StephenRJohns/sienna_camper/gemini_dimensions_prompt.md

I'm building a camper conversion platform for a Toyota Sienna minivan (fill in exact year and trim, e.g. "2022 Toyota Sienna XLE") and need precise cargo-area dimensions and obstruction locations for the specific configuration below. I'm using these numbers to build a parametric 3D model, so I need real measurements or the most authoritative estimates you can find (owner's manual specs, dimensional diagrams, teardown/conversion write-ups), with a source or reasoning for each — not a guess presented as fact. Where you're not confident, say so explicitly rather than rounding to a plausible-sounding number.

**Configuration:** 2nd row seats installed and pushed/slid fully forward on their tracks (not removed). 3rd row seats folded flat into the floor well. Cargo build sits on top of the folded 3rd row and behind the compressed 2nd row.

## Dimensions needed

1. **Maximum usable interior length**, measured from the inside face of the closed rear liftgate/hatch to the back of the 2nd-row seats when they are pushed fully forward on their tracks. Note if this changes between the floor level and up higher (liftgates are often curved, reducing usable length near the top).
2. **Maximum floor width** at the narrowest point between the wheel wells (this is usually the binding width constraint, not the overall interior width).
3. **Width at deck height** — if I build a platform ~11-13" above the floor, is the usable width wider than at floor level (i.e., do the wheel wells taper outward above floor level, or stay the same)?
4. **Maximum height** from the load floor to the headliner/ceiling directly above the cargo area (not above the front seats).
5. **Load floor shape**: is it flat, or does it have humps, a spare-tire bulge, tie-down anchor points, or a subwoofer box that would intrude into a flat platform's footprint? Give locations and heights of anything that isn't flat.

## Obstructions and required access (critical — don't just give me a bounding box)

6. **Rear HVAC/heat vents**: exact location (height from floor, distance from the rear liftgate opening) and size of any rear-seat heating/ventilation ducts or vent openings on the side walls or floor of the cargo area. I need to leave these physically uncovered/accessible, not just clear of a collision — tell me the full opening dimensions, not just how far they intrude.
7. **12V outlets / USB ports / household AC outlet**: locations of any power outlets in or near the cargo area (third-row area, cargo walls, or front console if a household AC outlet is present on this trim) that I need to keep reachable — exact position relative to the cargo floor and walls.
8. **Tie-down anchors / cargo hooks**: locations, since I may want to use them to secure a module rather than drilling into the floor.
9. **Liftgate interior curvature**: how far the closed liftgate's interior trim intrudes into the cargo space at various heights (floor level, mid-height, near the top) — I need this to avoid building anything that collides with the liftgate when closed.
10. **2nd-row seat track travel**: how far forward the 2nd-row seats can actually slide, and whether "fully forward" still leaves any seat-frame structure (rails, recline mechanism, anchor points) protruding into the cargo area behind it that a flat platform edge would need to clear.
11. **Wheel well intrusion shape**: is the wheel well intrusion a simple rectangular step, or does it curve/taper? I need enough shape detail to know if a rectangular module can sit flush against it or needs a notched corner.

## Format

Give me a clean list of numbers with units (inches), each with a one-line source/confidence note (e.g., "from Toyota's official cargo dimension spec," "estimated from owner forum measurements," "estimated from comparable-generation teardown photos — verify in person"). Flag anything you're not confident about instead of stating it as fact.
