StephenRJohns/sienna_camper/renders/side-passenger.png

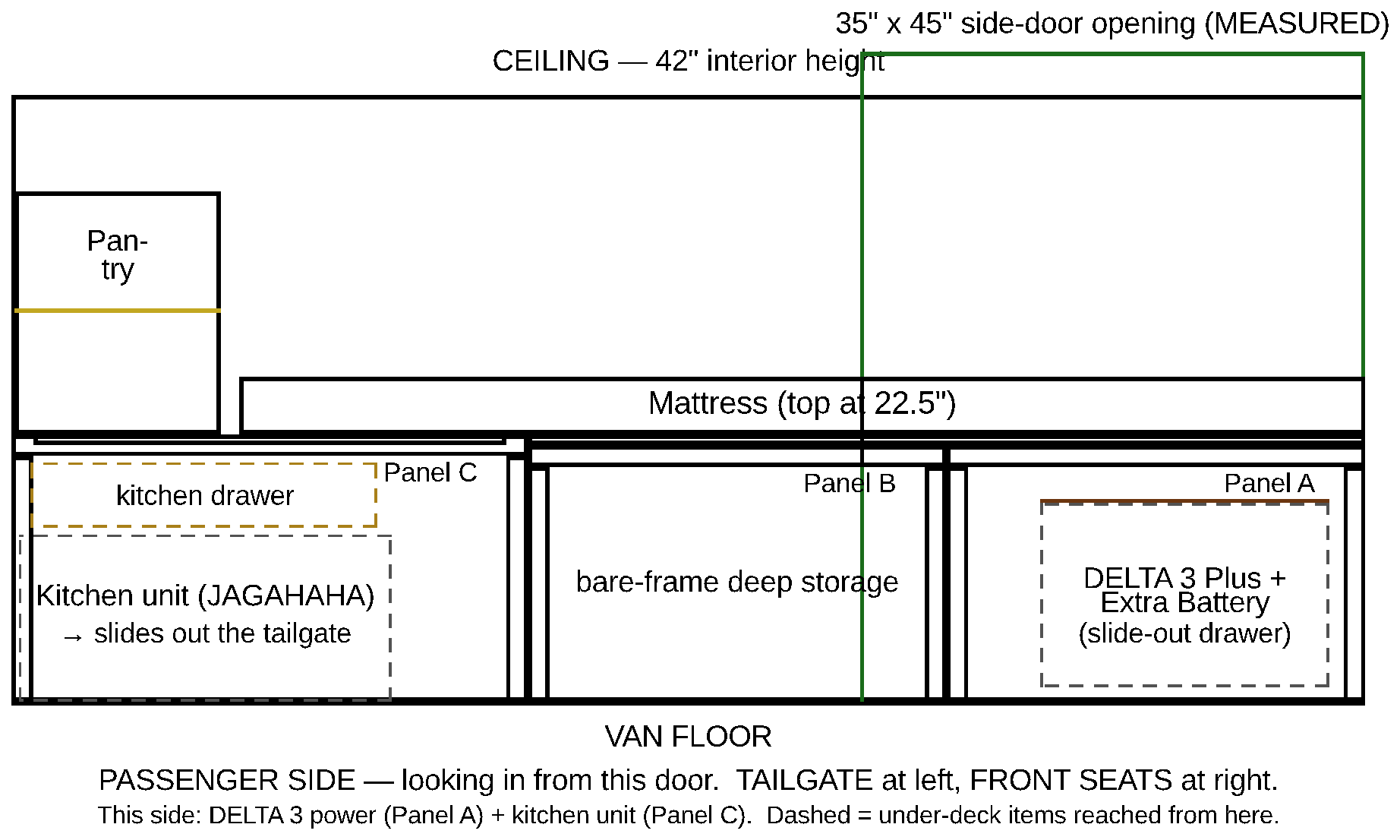
renders/side-passenger.png
