StephenRJohns/sienna_camper/renders/survey-f1.png

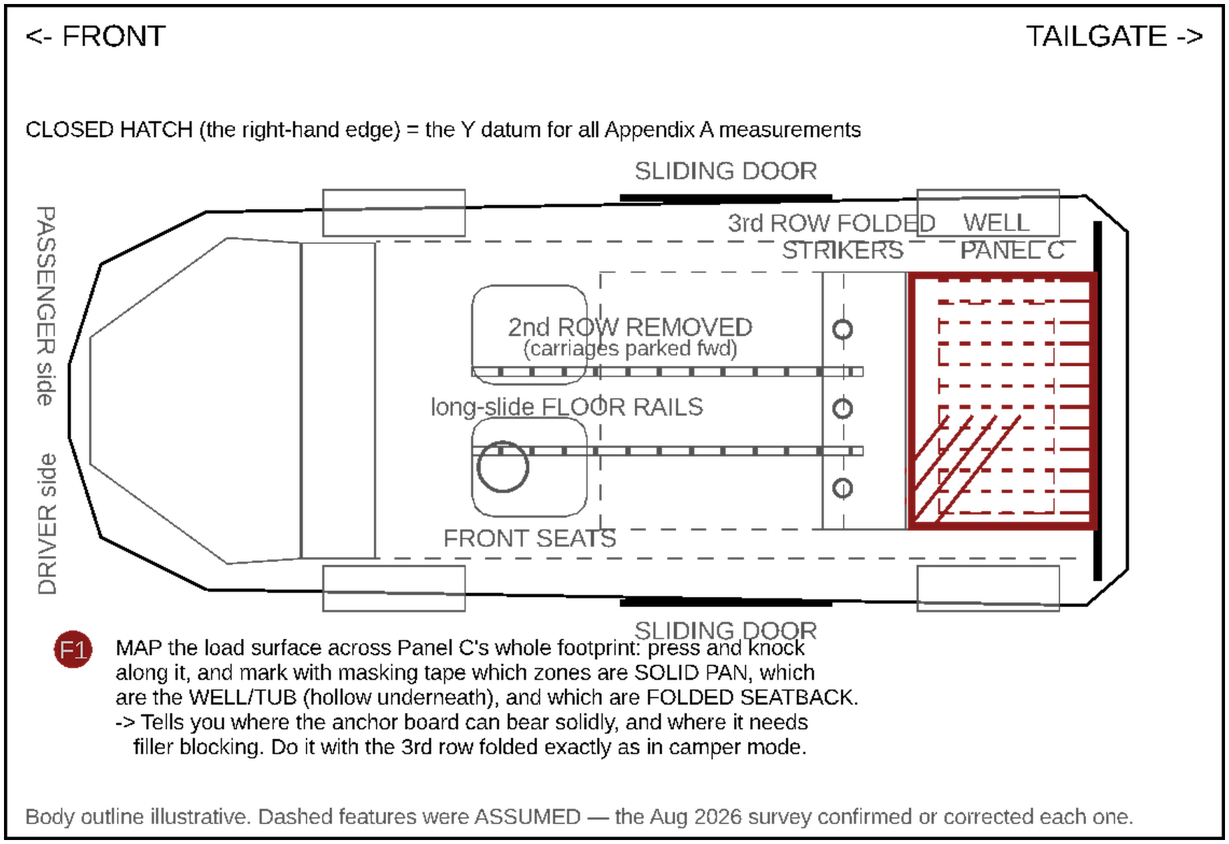
renders/survey-f1.png
