StephenRJohns/sienna_camper/v1.png

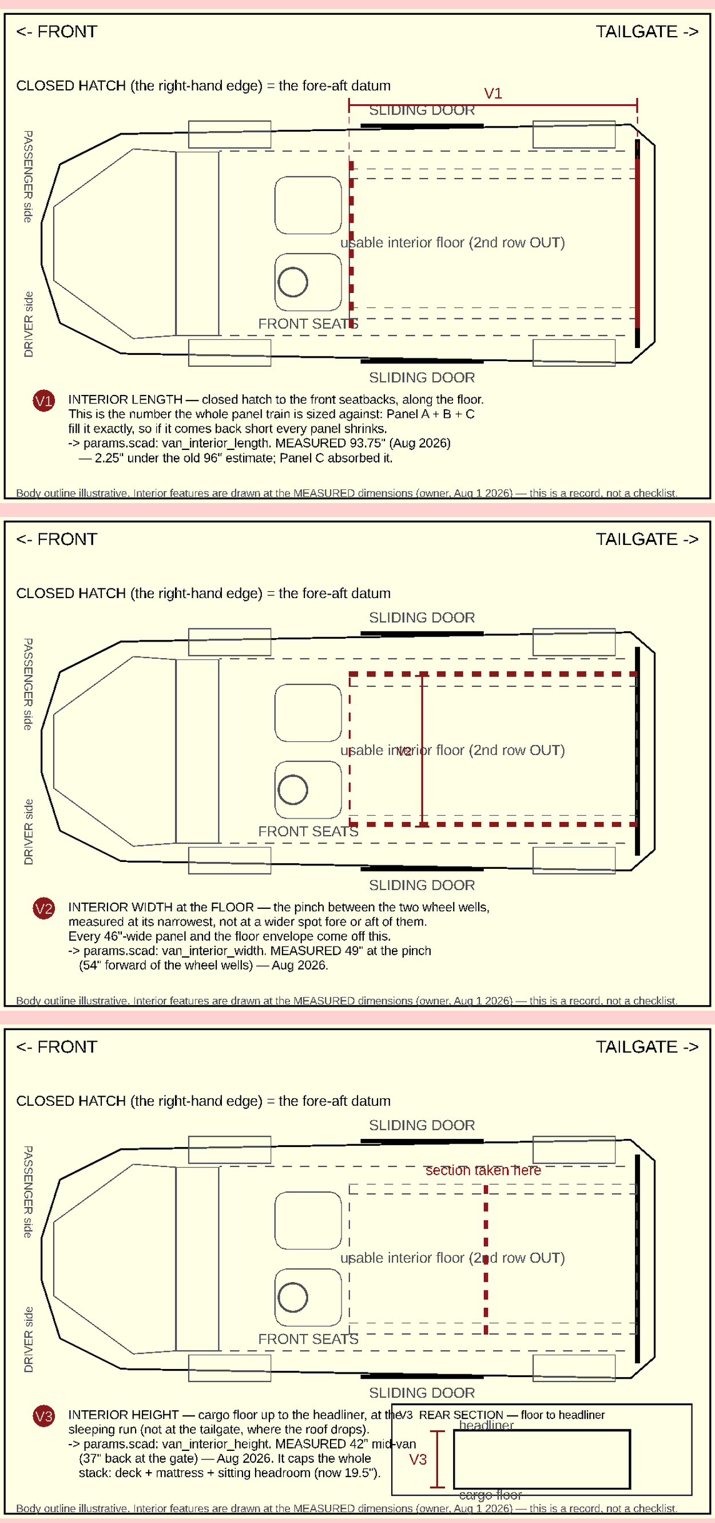
v1.png
