StephenRJohns/sienna_camper/v2.png

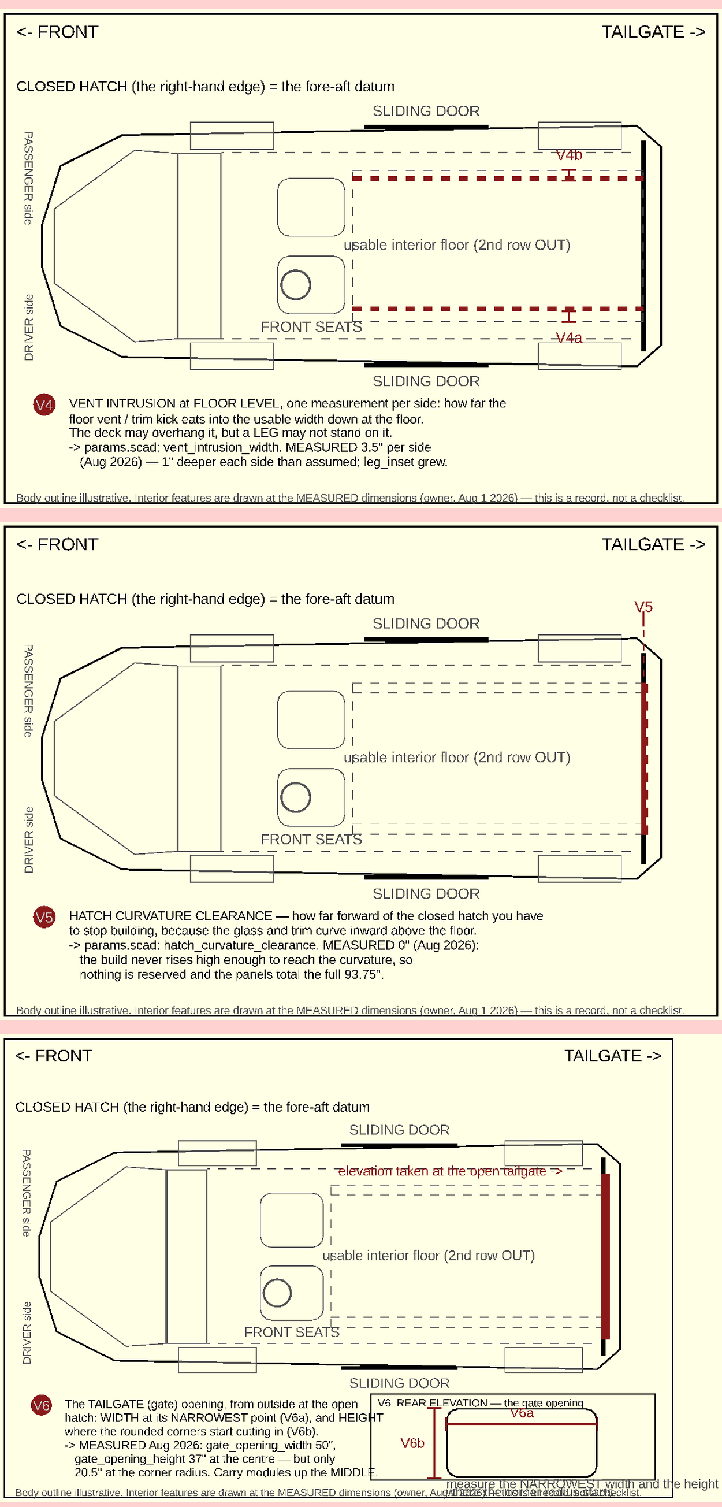
v2.png
