StephenRJohns/sienna_camper/v7c.png

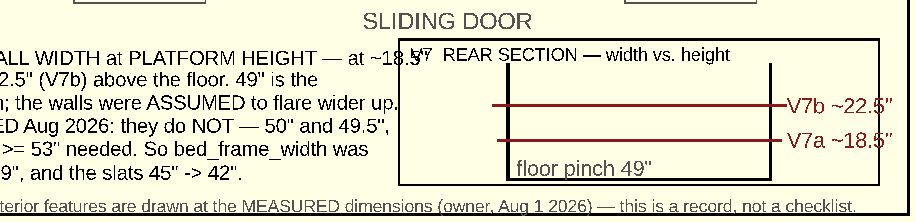
v7c.png
