StephenRJohns/sienna_camper/v89.png

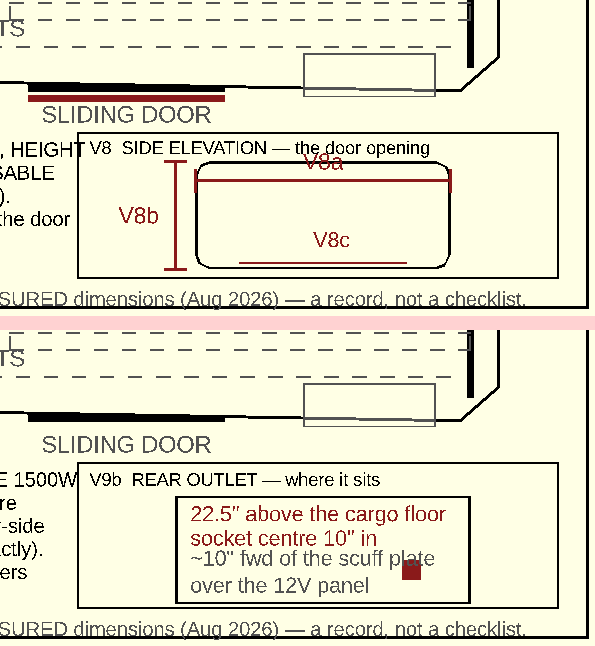
v89.png
