StephenRJohns/sienna_camper/v457.png

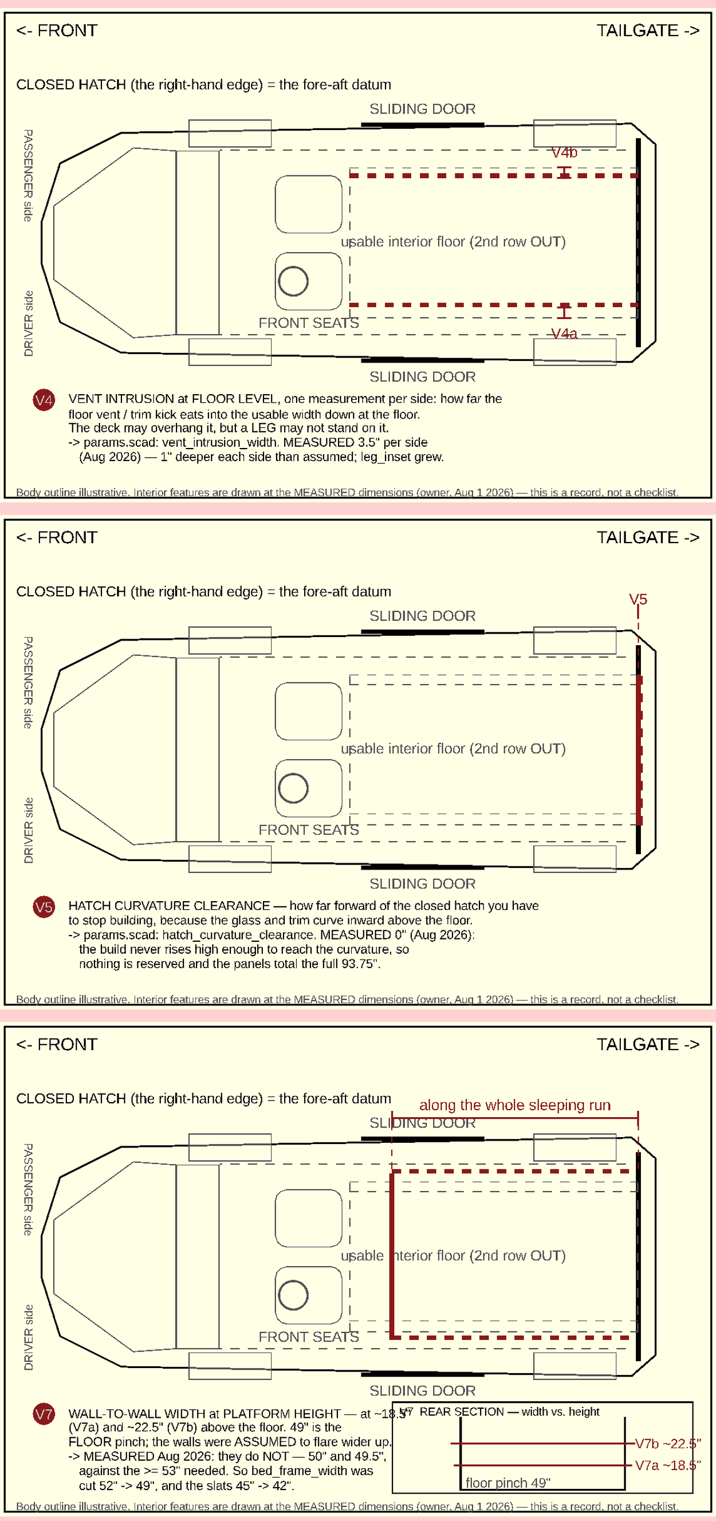
v457.png
