StephenRJohns/sienna_camper/vall.png

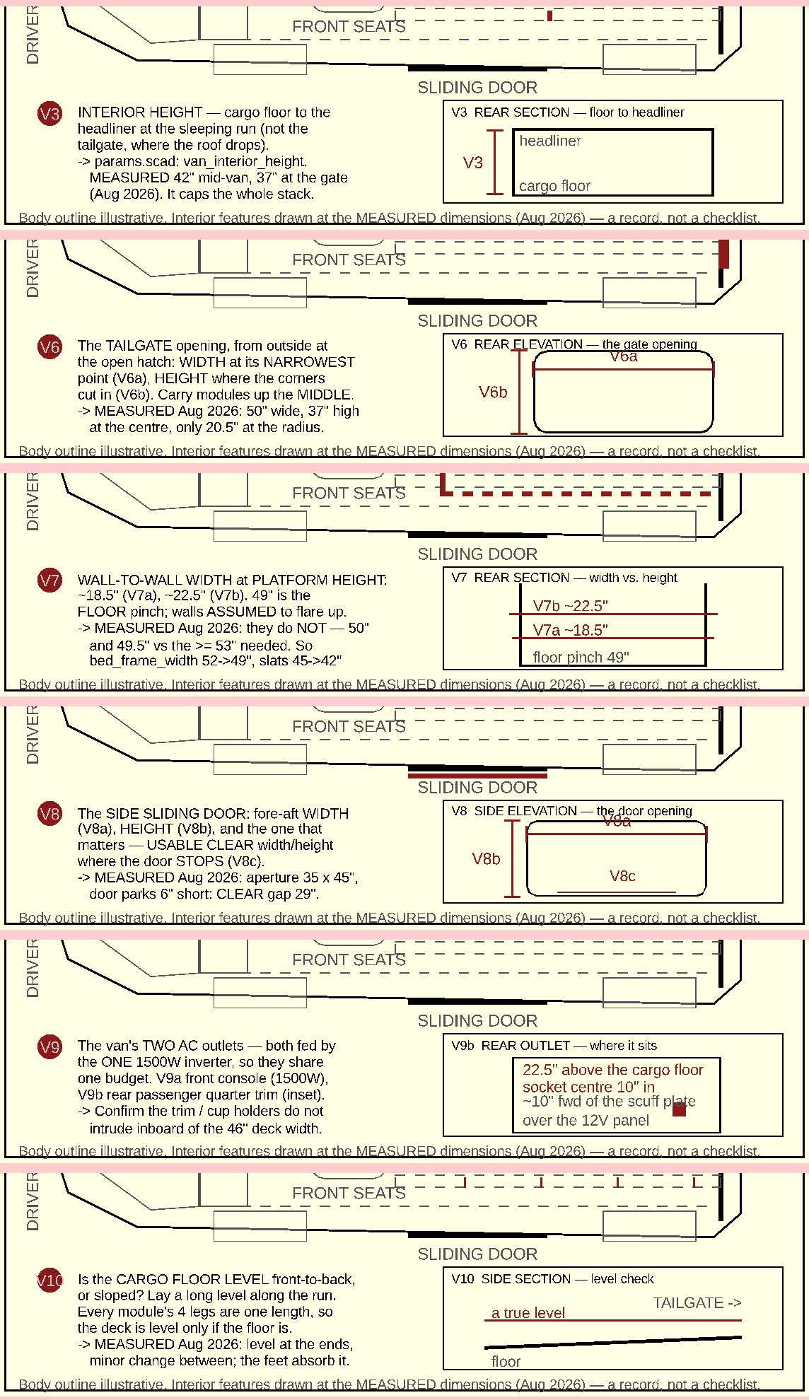
vall.png
