StephenRJohns/sienna_camper/vins.png

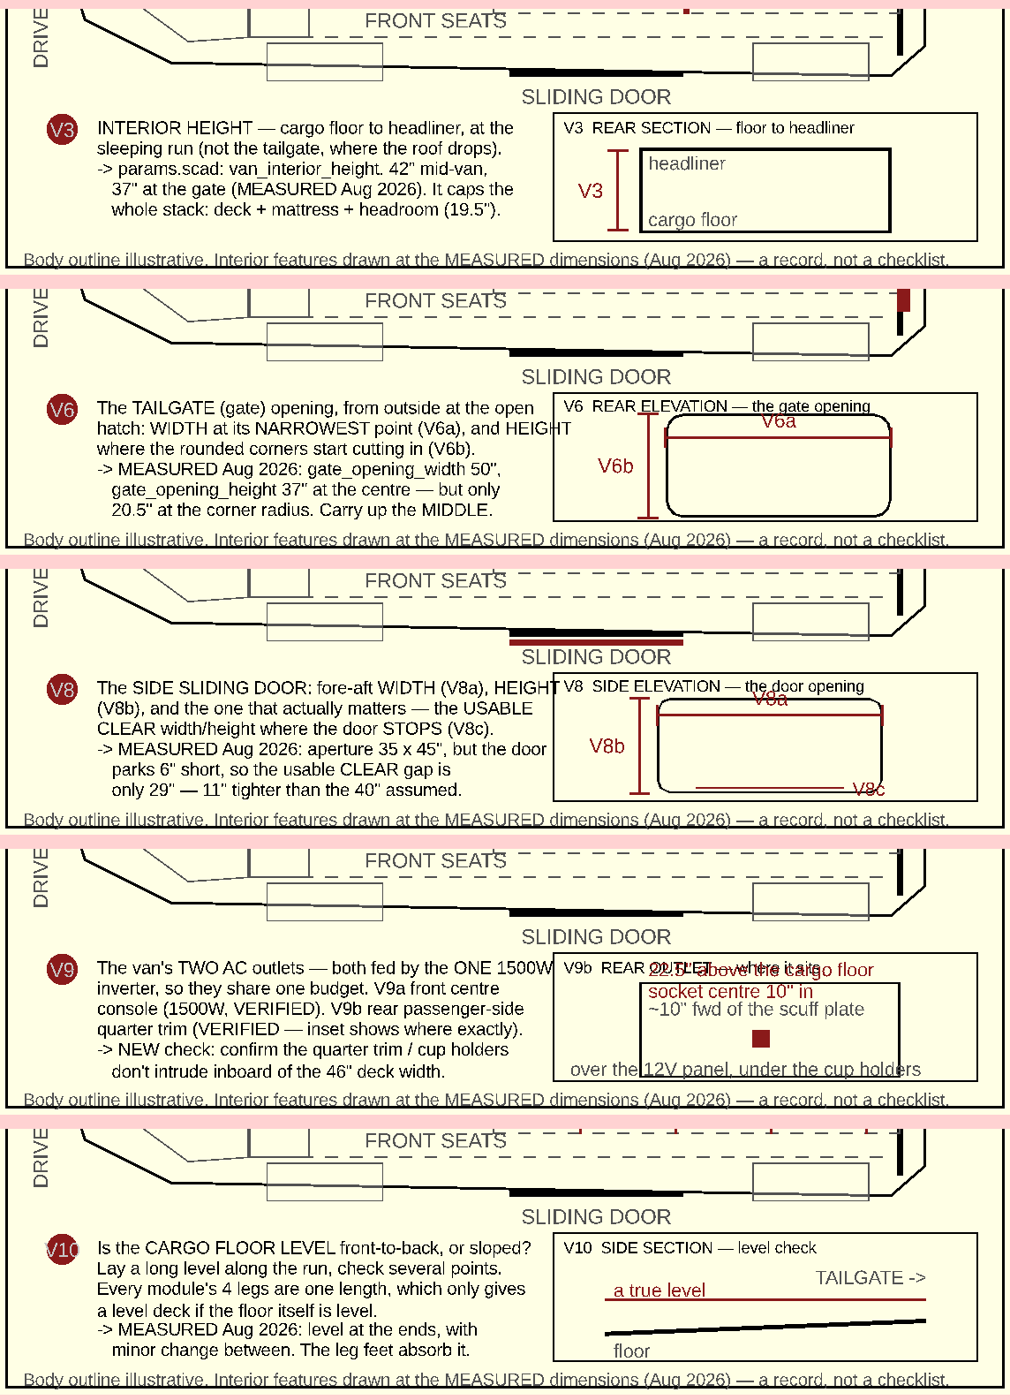
vins.png
