StephenRJohns/sienna_camper/home-depot-order-sheet.pdf

# Home Depot Pro Desk — Materials Order

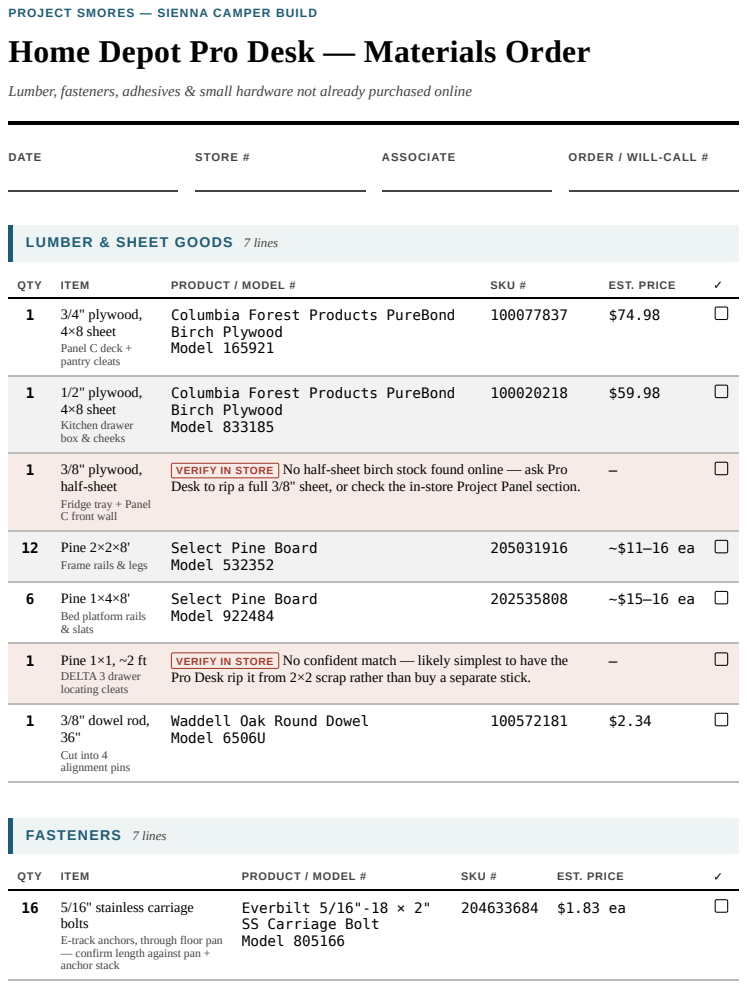
[picture p101: page 1]
DATE; STORE #; ASSOCIATE; ORDER / WILL-CALL #; QTY; ITEM; PRODUCT / MODEL #; SKU #; EST. PRICE; 1 3/4" plywood, 4×8 sheet Panel C deck + pantry cleats; FASTENERS 7 lines

PROJECT SMORES — SIENNA CAMPER BUILD

Lumber, fasteners, adhesives & small hardware not already purchased online

LUMBER & SHEET GOODS 7 lines

Columbia Forest Products PureBond
Birch Plywood
Model 165921

1 1/2" plywood, | 4×8 sheet Kitchen drawer box & cheeks | Columbia Forest Products PureBond Birch Plywood Model 833185 | 100020218 | $59.98

1 3/8" plywood, | half-sheet Fridge tray + Panel C front wall | VERIFY IN STORE No half-sheet birch stock found online — ask Pro Desk to rip a full 3/8" sheet, or check the in-store Project Panel section. | | —

12 Pine 2×2×8' | Frame rails & legs | Select Pine Board Model 532352 | 205031916 | ~$11–16 ea

6 Pine 1×4×8'
Bed platform rails
& slats
1 Pine 1×1, ~2 ft
DELTA 3 drawer
locating cleats
1 3/8" dowel rod,
Cut into 4
alignment pins

Select Pine Board
Model 922484

VERIFY IN STORE No confident match — likely simplest to have the
Pro Desk rip it from 2×2 scrap rather than buy a separate stick.

Waddell Oak Round Dowel
Model 6506U

16 5/16" stainless carriage
bolts
E-track anchors, through floor pan
— confirm length against pan +
anchor stack

Everbilt 5/16"-18 × 2"
SS Carriage Bolt
Model 805166

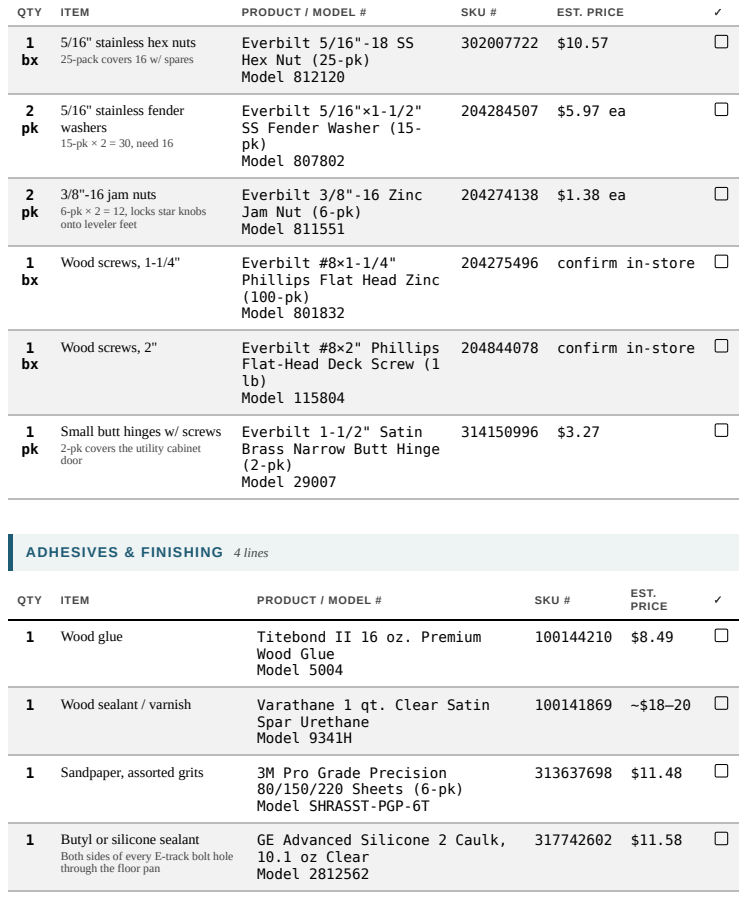
[picture p102: page 2]
QTY; ITEM; PRODUCT / MODEL #; SKU #; EST. PRICE; 5/16" stainless fender washers 15-pk × 2 = 30, need 16; Wood screws, 1-1/4"; Everbilt #8×1-1/4"; Wood screws, 2"; Everbilt #8×2" Phillips; confirm in-store; Wood glue; Titebond II 16 oz. Premium; Wood Glue Model 5004; Wood sealant / varnish; Varathane 1 qt. Clear Satin; Spar Urethane Model 9341H; Sandpaper, assorted grits; 3M Pro Grade Precision

5/16" stainless hex nuts
25-pack covers 16 w/ spares

Everbilt 5/16"-18 SS
Hex Nut (25-pk)
Model 812120

Everbilt 5/16"×1-1/2"
SS Fender Washer (15-
Model 807802

3/8"-16 jam nuts
6-pk × 2 = 12, locks star knobs
onto leveler feet

Everbilt 3/8"-16 Zinc
Jam Nut (6-pk)
Model 811551

204275496 confirm in-store

Phillips Flat Head Zinc
Model 801832

Flat-Head Deck Screw (1
Model 115804

Small butt hinges w/ screws
2-pk covers the utility cabinet
door

Everbilt 1-1/2" Satin
Brass Narrow Butt Hinge
Model 29007

ADHESIVES & FINISHING 4 lines

80/150/220 Sheets (6-pk)
Model SHRASST-PGP-6T

1 Butyl or silicone sealant
Both sides of every E-track bolt hole
through the floor pan

GE Advanced Silicone 2 Caulk,
10.1 oz Clear
Model 2812562

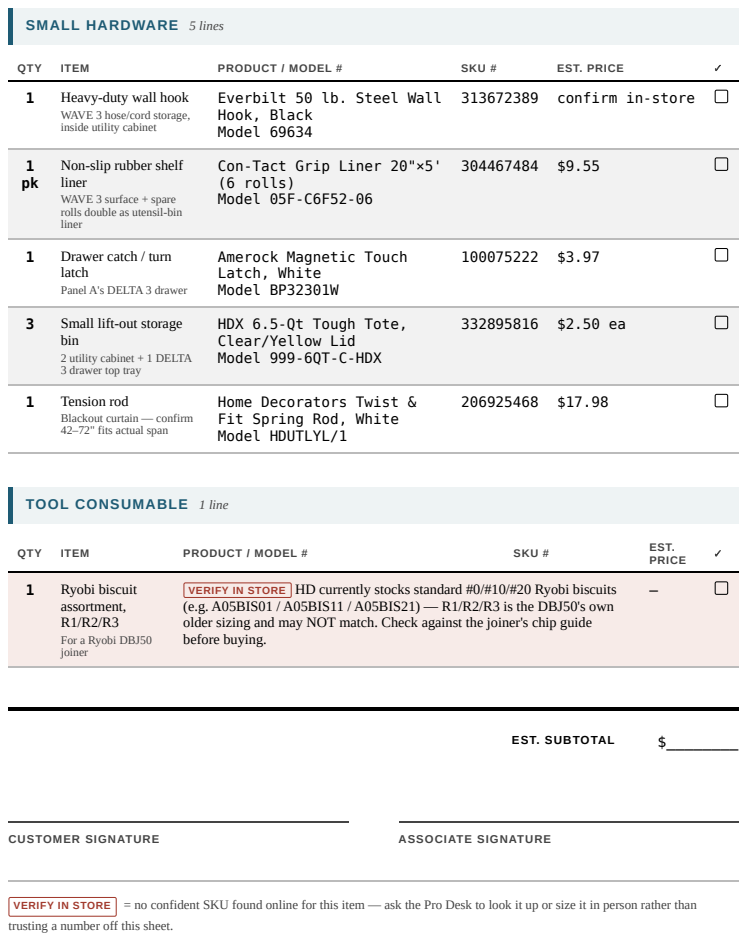
[picture p103: page 3]
QTY; ITEM; PRODUCT / MODEL #; SKU #; EST. PRICE; 1 Ryobi biscuit assortment, R1/R2/R3 For a Ryobi DBJ50 joiner; EST. SUBTOTAL; CUSTOMER SIGNATURE; ASSOCIATE SIGNATURE

SMALL HARDWARE 5 lines

1 Heavy-duty wall hook
WAVE 3 hose/cord storage,
inside utility cabinet

Everbilt 50 lb. Steel Wall
Hook, Black
Model 69634

313672389 confirm in-store

Non-slip rubber shelf
liner
WAVE 3 surface + spare
rolls double as utensil-bin
1 Drawer catch / turn
latch
Panel A's DELTA 3 drawer

Con-Tact Grip Liner 20"×5'
(6 rolls)
Model 05F-C6F52-06

Amerock Magnetic Touch
Latch, White
Model BP32301W

3 Small lift-out storage
bin
2 utility cabinet + 1 DELTA
3 drawer top tray
1 Tension rod
Blackout curtain — confirm
42–72" fits actual span

HDX 6.5-Qt Tough Tote,
Clear/Yellow Lid
Model 999-6QT-C-HDX

Home Decorators Twist &
Fit Spring Rod, White
Model HDUTLYL/1

TOOL CONSUMABLE 1 line

VERIFY IN STORE HD currently stocks standard #0/#10/#20 Ryobi biscuits
(e.g. A05BIS01 / A05BIS11 / A05BIS21) — R1/R2/R3 is the DBJ50's own
older sizing and may NOT match. Check against the joiner's chip guide
before buying.

VERIFY IN STORE = no confident SKU found online for this item — ask the Pro Desk to look it up or size it in person rather than
trusting a number off this sheet.
