StephenRJohns/sienna_camper/fridge_install_detail.scad

// ============================================================
// Fridge installation detail — zoomed top-down view of Panel C
// ============================================================
// The whole-vehicle top_view.scad is too small-scale to label the
// fridge's 2 fans, temperature sensor, cabinet door, and floor
// anchors clearly (they're packed into Panel C's 46in x 36in
// footprint). This file draws JUST Panel C, at a scale where every
// component gets its own numbered marker — pairs with rear_view.scad
// (elevation), fridge_slide_detail.scad (the slide mechanism, side
// profile), and fridge_wiring.scad (the electrical side).
//
// Numbered markers + a side list (not inline labels scattered across
// the drawing) — an early draft tried inline labels and every one of
// them collided with something else in this tight a footprint.
//
// AIRFLOW (owner question, July 2026): the intake fan on Panel C's
// FRONT wall blows cabin air IN, it crosses the fridge's compressor
// end, and the exhaust fan on the fridge bay's RIGHT (kitchen-
// facing) side blows it INTO the utility cabinet — the door isn't
// airtight, so it leaks back out around the edges. Arrows drawn.
// The control panel lives in the OPEN utility bay between the
// fridge and kitchen (no door — the old hinged, louvered door was
// cut as pointless), on a backer board hung from the deck underside
// (the 3/4" sheet's offcut) — reach it by hand. Also here: the
// NO-DRILL ANCHOR BOARD for both the fridge's slide and the kitchen
// unit — a rubber mat + ONE comb-shaped 3/4in ply board (full-width
// bridge + 3 strips, continuous, no wood joints), its steel
// tongues bolted to the rear ends of the 2nd-row long-slide floor
// rails (fallback: butting the striker-row step) and strapped to
// the 3 3rd-row striker loops — see "Securing heavy components"
// (Section 8) for why the factory cargo hooks aren't used for
// either, and why nothing bolts to the van (owner: no holes).
//
// COORDINATE SYSTEM (also used in the build-plan coordinate table):
// origin (0,0) is Panel C's TAILGATE-FACING, LEFT corner, at floor
// level (as you'd stand at the open tailgate facing forward into the
// van). X increases to the RIGHT, 0 to 46in (panel_width). Y
// increases FORWARD (toward the Panel B seam), 0 to 36in
// (panel_c_length). This is the reverse of top_view.scad's own
// internal Y convention (increases toward the FRONT of the whole
// vehicle) and platform.scad's true 3D model convention (increases
// toward the TAILGATE) — both exist for other reasons already
// explained in their own files. This one reads most naturally for
// "how far in from the tailgate, how far over from the left" — the
// two questions you actually ask while installing something back
// here.
//
// Render with: openscad -o renders/fridge-install-detail.svg fridge_install_detail.scad
// ============================================================
// LEGIBILITY (Aug 2026): 6 prose line(s) moved out of this
// sheet into the document, and every text size scaled x2.4. Those
// sentences were setting the sheet's width, and a figure's printed
// text height is size x (page_width / sheet_width) — so they were
// holding every other label on the sheet down to 3-6pt on paper.
// Keep prose in the markdown; this sheet carries geometry and short
// labels only.

include <params.scad>
include <colors.scad>

stroke = 0.25;

module rect_outline(w, l, s = stroke) {
    color("black")
    difference() {
        square([w, l]);
        translate([s, s]) square([w - 2*s, l - 2*s]);
    }
}

module label(txt, x, y, size = 3.36) {
    color("black")
    translate([x, y]) text(txt, size = size, halign = "center", valign = "center");
}

module label_left(txt, x, y, size = 2.88) {
    color("black")
    translate([x, y]) text(txt, size = size, halign = "left", valign = "center");
}

// Numbered marker: a filled circle with a white number, used in the
// drawing; the matching number in the side list gives the real
// coordinates, description, and fastener spec.
// nx: which side the numeral sits on (+ right, - left). OpenSCAD merges
// TOUCHING 2D shapes into one polygon set and paints them a single colour, so
// a white numeral inside a filled circle disappears — every marker on this
// sheet rendered as an unreadable coloured blob. The numeral goes beside the
// icon instead, on whichever side is clear.
module marker(n, x, y, col, nx = 2.1) {
    // numbered AND hue-coded (marker_col, colors.scad) — number
    // pairs to the table row, color separates markers at a glance
    translate([x, y]) {
        color(marker_col(n)) circle(r = 1.3);
        color(marker_col(n)) translate([nx, 0])
            text(str(n), size = 3.0, halign = nx > 0 ? "left" : "right",
                 valign = "center");
    }
}

// anchor-board strip (mat + 3/4in ply) — drawn as an outline with
// diagonal section-hatching so it stays LINE ART (filled shapes
// union into solid blobs in OpenSCAD's monochrome SVG export) —
// the no-drill securing chassis, Section 8
module board_strip(x0, y0, w, l) {
    board_poly([[x0, y0], [x0 + w, y0], [x0 + w, y0 + l], [x0, y0 + l]]);
}
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
