StephenRJohns/sienna_camper/sienna-powerfold-guide/docs/sources.md

# Sources

## Primary thread

**Power Folding Side Mirror + Extra features** — SiennaChat, started April 2022 by jays3l33t
https://www.siennachat.com/threads/power-folding-side-mirror-extra-features.70616/

| Page | What's there |
|---|---|
| [page-2](https://www.siennachat.com/threads/power-folding-side-mirror-extra-features.70616/page-2) | Kit sourcing, first video reference |
| [page-4](https://www.siennachat.com/threads/power-folding-side-mirror-extra-features.70616/page-4) | Door wiring photos both sides, switch panel swap, the 19 mm / 13 mm explanation |
| [page-5](https://www.siennachat.com/threads/power-folding-side-mirror-extra-features.70616/page-5) | Mirror glass removal, broken motor housing, connector detail, 7/10 difficulty rating, spring compressor workaround |
| [page-6](https://www.siennachat.com/threads/power-folding-side-mirror-extra-features.70616/page-6) | Vibration + angle-adjustment failure reports, extra wire |
| **page-7** | **Clearest cylinder-release account: "ignore the spring, you're clearing the ears from a pocket." NOT YET CITED IN THE PDF.** |
| [page-8](https://www.siennachat.com/threads/power-folding-side-mirror-extra-features.70616/page-8) | Spring and lock-ring procedure, half-turn method |

## Other threads

- [Power folding mirrors: a quest to find a complete guide for a newbie](https://www.siennachat.com/threads/power-folding-mirrors-a-quest-to-find-a-complete-guide-for-a-newbie.71100/) — SiennaChat
- [Power Folding Mirror Installation](https://www.toyotanation.com/threads/power-folding-mirror-installation.1713897/) — Toyota Nation
- [DIY: Power Folding Mirrors](https://www.toyotanation.com/threads/diy-power-folding-mirrors.1723392/) — Toyota Nation

## Video

**In the PDF already:**
- Kit install walkthrough (full teardown and reassembly) — https://www.youtube.com/watch?v=CE5dYUq1FOg

**Verified, not yet in the PDF.** These cover factory disassembly for the 2021-2026
generation. None of them cover the power-fold retrofit itself — a stock mirror never comes
apart as far as the spring and lock collar.

| Covers | Maps to | Link |
|---|---|---|
| Front door interior trim panel removal/installation | Step 1 | https://www.youtube.com/watch?v=7l6Sri5Bh-k |
| Outer rear view door mirror assembly removal/installation | Step 2 | https://www.youtube.com/watch?v=SGXrkRrwaZI |
| Outer mirror glass removal, testing, installation (heater + BSM) | Step 3 | https://www.youtube.com/watch?v=Nt2K813kGyM |
| Complete side mirror removal, 2021-2025 | Step 2-3 | https://www.youtube.com/watch?v=16NexCDccqM |

**Fly-to-the-sky series** (Russian narration, linked from thread post #73):
- part 1 — door cover disassembly, 7:38 — https://www.youtube.com/watch?v=RVMblSaYvDg
- part 2+ — **not yet located.** Search engines don't index this 353-subscriber channel.
  To find: open part 1, click the channel name, then the Videos tab. Part 2 most likely
  covers the mirror teardown itself, which is the section the guide most needs.

Note the video ID uses a lowercase `l`, not the digit `1`: `RVMblSaYvDg`.

## Caveats carried into the document

- Kit contents and switch behaviour vary between sellers of superficially identical kits.
- The 13 mm / 19 mm sizes come from an installer's written account cross-referenced
  against photos, not from a spec sheet. Verify against the tool in hand.
- The extra-features wire behaviour (auto windows on lock, one-touch windows, hazard
  flash on park) is reported by owners, not documented by the seller.
