StephenRJohns/sienna_camper/renders/steps/step-05-build-drawers.png

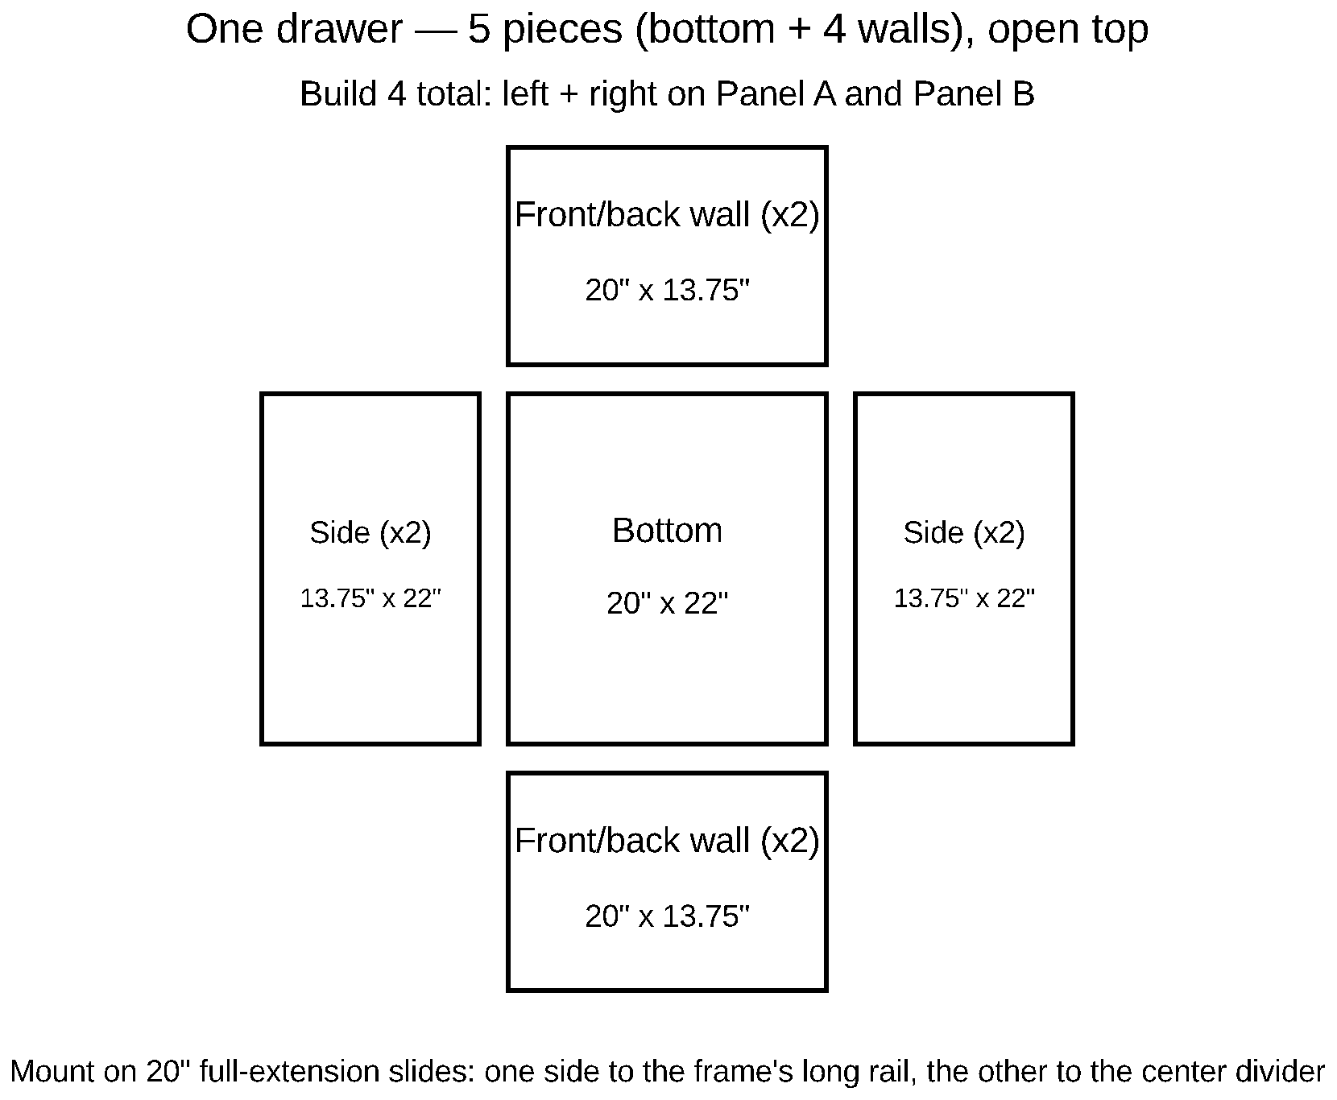
renders/steps/step-05-build-drawers.png
