StephenRJohns/sienna_camper/sienna-powerfold-guide/src/images/0CD25CF37BA9B22EA1CC5D0093E6C3DA.jpg

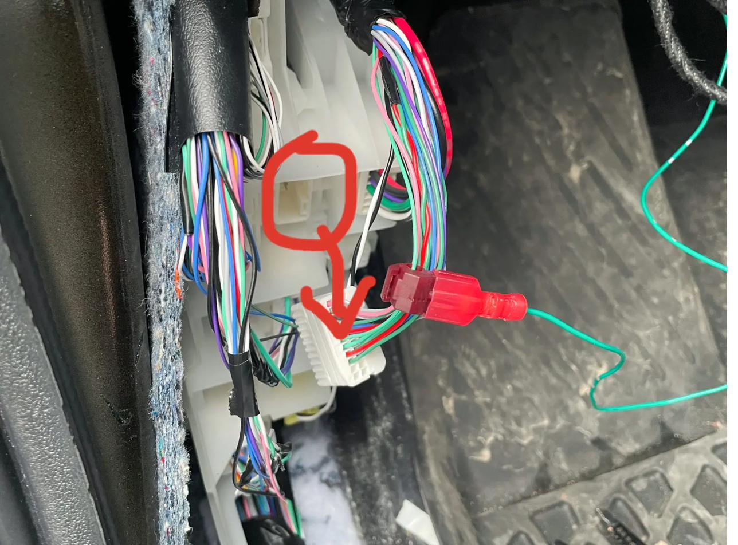
sienna-powerfold-guide/src/images/0CD25CF37BA9B22EA1CC5D0093E6C3DA.jpg
