StephenRJohns/sienna_camper/sienna-powerfold-guide/src/images/1EE6338432E34F99A4A7298FA6377FF1.jpeg

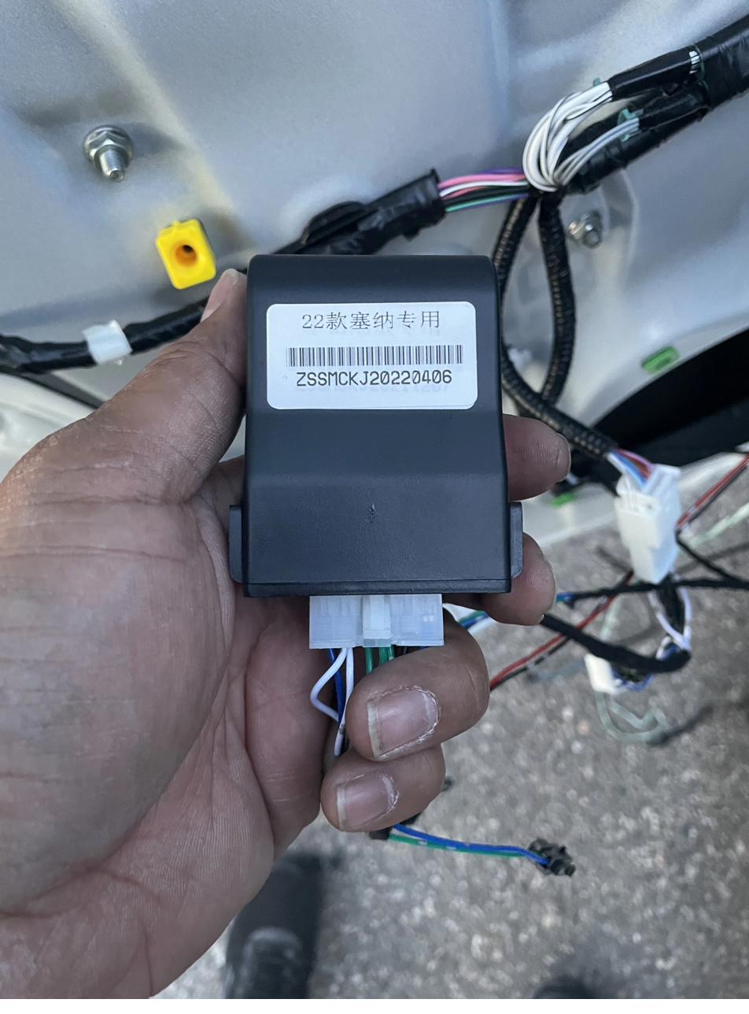
sienna-powerfold-guide/src/images/1EE6338432E34F99A4A7298FA6377FF1.jpeg
