StephenRJohns/sienna_camper/sienna-powerfold-guide/src/images/2AF3C3A1CB1F48D2A40DF06FE2FEA097.jpeg

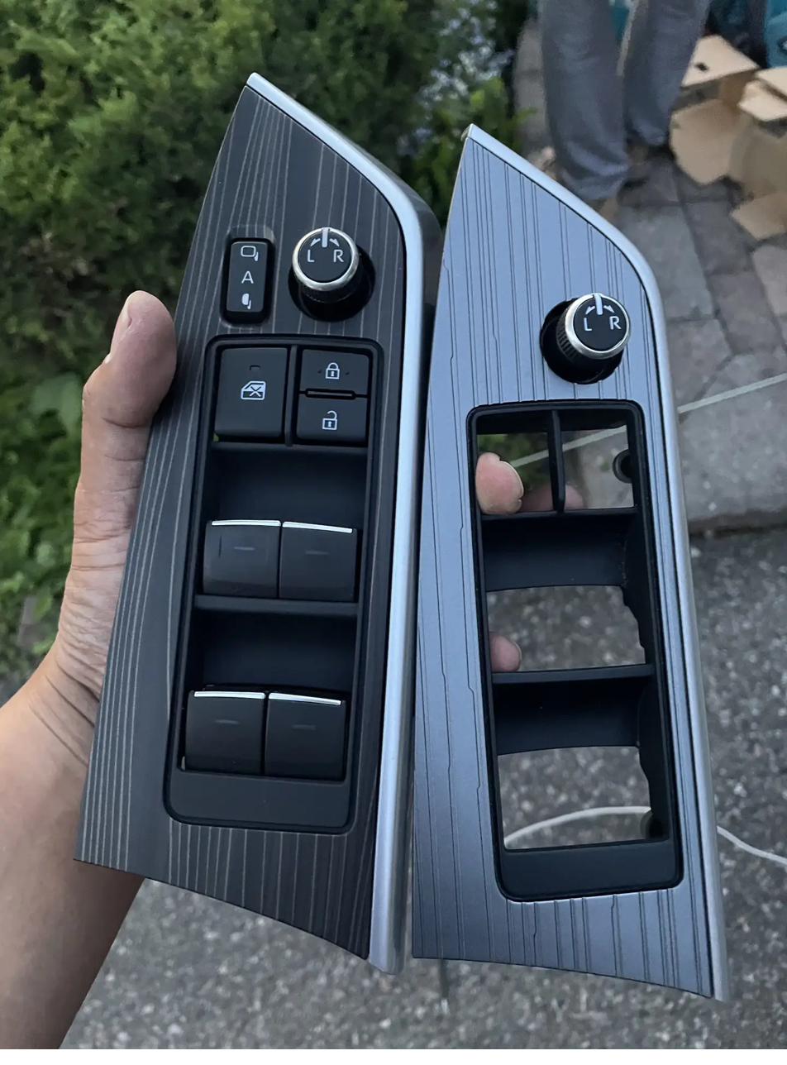
sienna-powerfold-guide/src/images/2AF3C3A1CB1F48D2A40DF06FE2FEA097.jpeg
