StephenRJohns/sienna_camper/sienna-powerfold-guide/src/images/4A9271E51A1144F180EBD049A3927BC4.jpeg

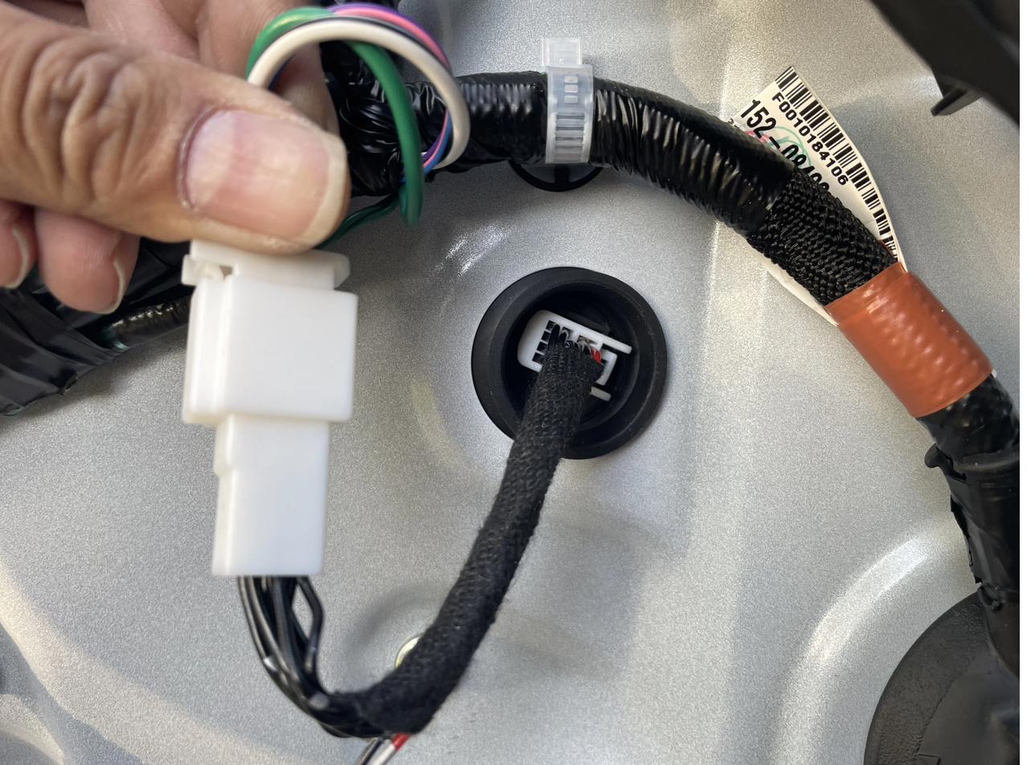
sienna-powerfold-guide/src/images/4A9271E51A1144F180EBD049A3927BC4.jpeg
