StephenRJohns/sienna_camper/sienna-powerfold-guide/src/images/4E527D38B37F4F2B9309F9CFCEE6375A.jpeg

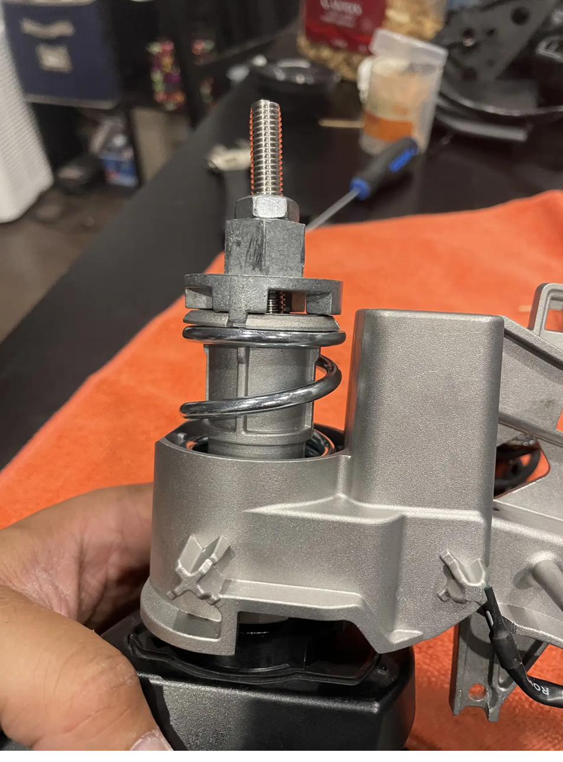
sienna-powerfold-guide/src/images/4E527D38B37F4F2B9309F9CFCEE6375A.jpeg
