StephenRJohns/sienna_camper/sienna-powerfold-guide/src/images/20F8E842F9744DB8B593697B1D22A8DA.jpeg

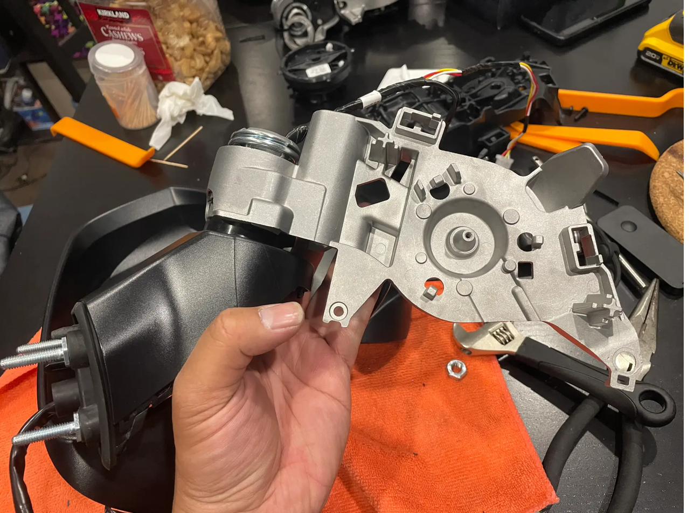
sienna-powerfold-guide/src/images/20F8E842F9744DB8B593697B1D22A8DA.jpeg
