StephenRJohns/sienna_camper/sienna-powerfold-guide/src/images/30D133B107C647388646B21AE5D5867F.jpeg

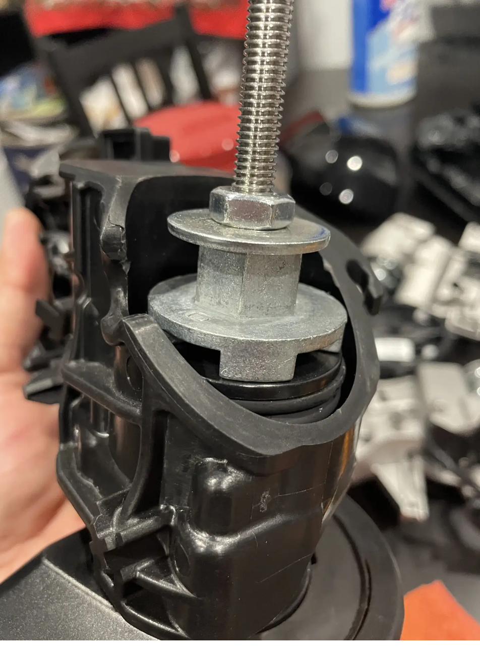
sienna-powerfold-guide/src/images/30D133B107C647388646B21AE5D5867F.jpeg
