StephenRJohns/sienna_camper/sienna-powerfold-guide/src/images/47F2D5E996AB41148CB396BFAD48F057.jpeg

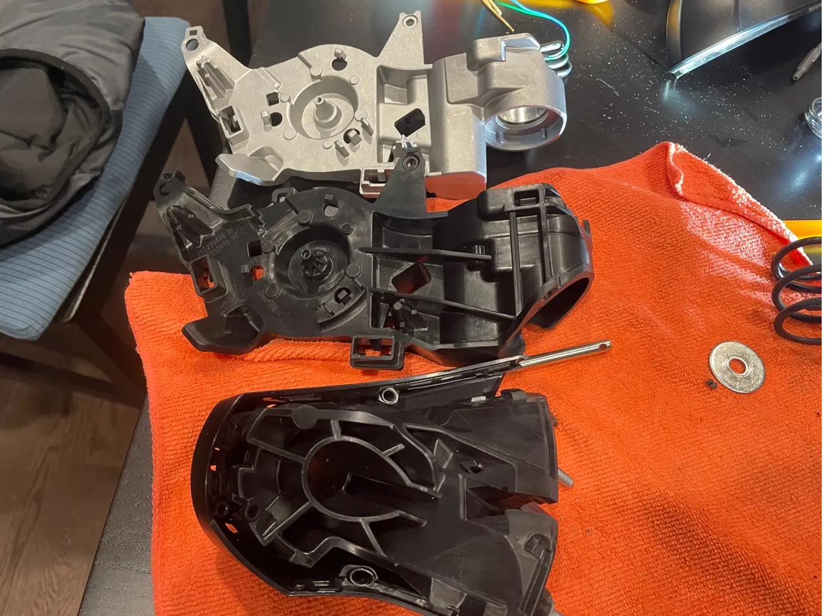
sienna-powerfold-guide/src/images/47F2D5E996AB41148CB396BFAD48F057.jpeg
