StephenRJohns/sienna_camper/sienna-powerfold-guide/src/images/99C088AB9D474BF0B8276D62D4E2E4B3.jpeg

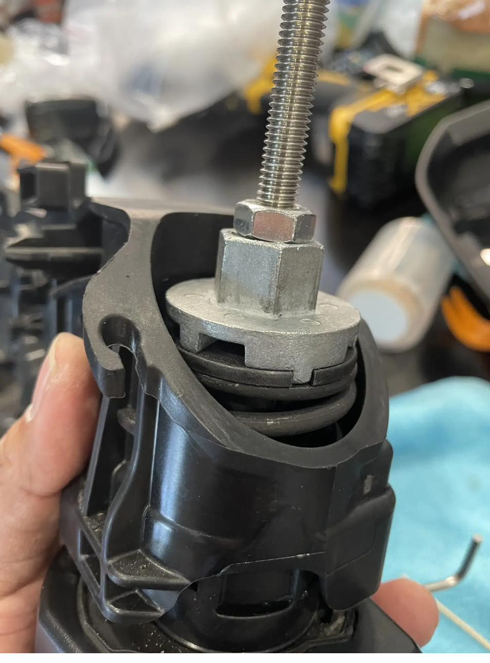
sienna-powerfold-guide/src/images/99C088AB9D474BF0B8276D62D4E2E4B3.jpeg
