StephenRJohns/sienna_camper/sienna-powerfold-guide/src/images/457FD7CD4B9B4814B6B3AA91F1E94096.jpeg

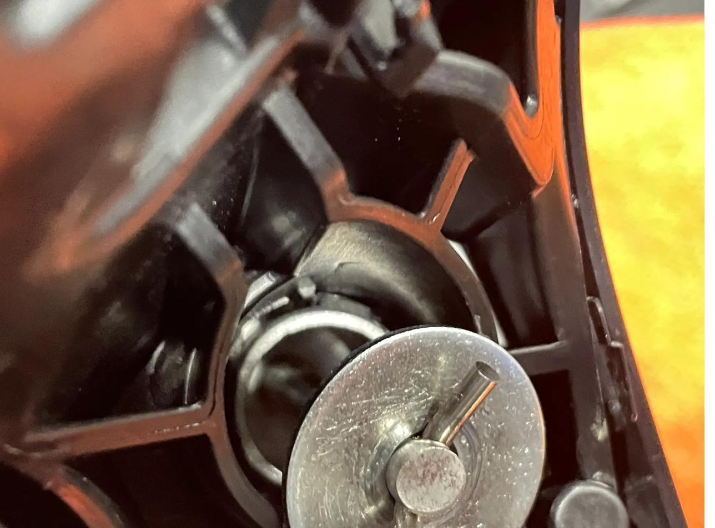
sienna-powerfold-guide/src/images/457FD7CD4B9B4814B6B3AA91F1E94096.jpeg
