StephenRJohns/sienna_camper/sienna-powerfold-guide/src/images/723A10D0BAA14821A0ADB34520CA412F.jpeg

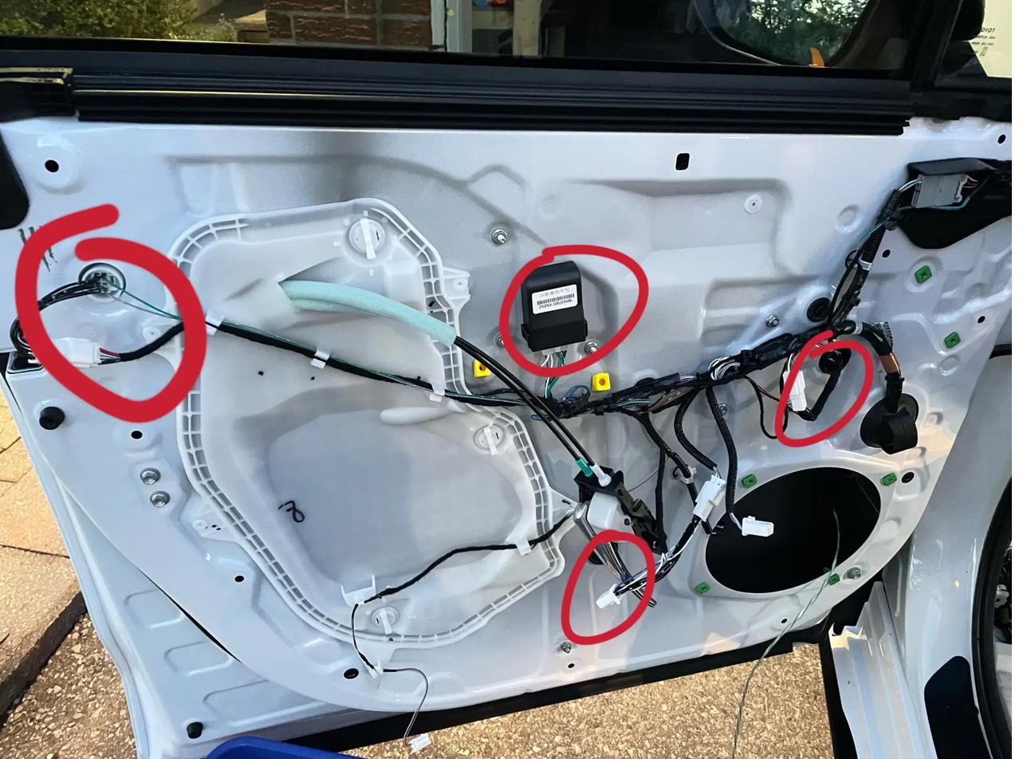
sienna-powerfold-guide/src/images/723A10D0BAA14821A0ADB34520CA412F.jpeg
