StephenRJohns/sienna_camper/sienna-powerfold-guide/src/images/755AD88FC62D4120939A6065415986C0.jpeg

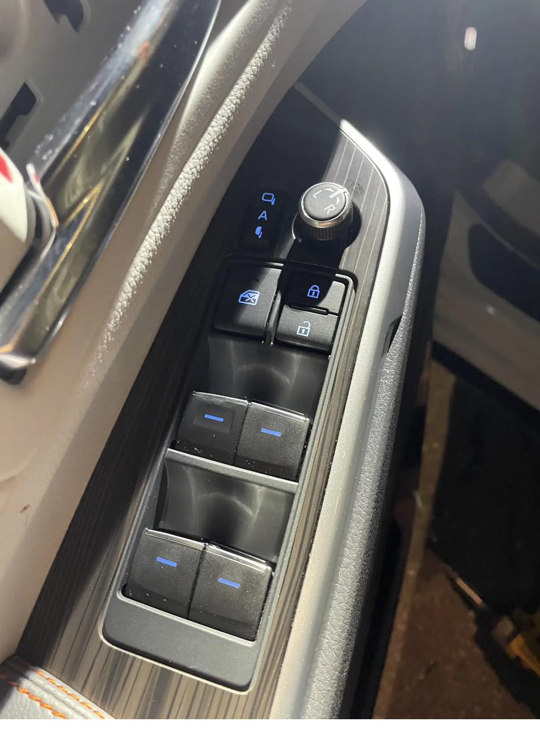
sienna-powerfold-guide/src/images/755AD88FC62D4120939A6065415986C0.jpeg
