StephenRJohns/sienna_camper/sienna-powerfold-guide/src/images/BC45070C37D3A08A4E5510C035B70BFF.jpg

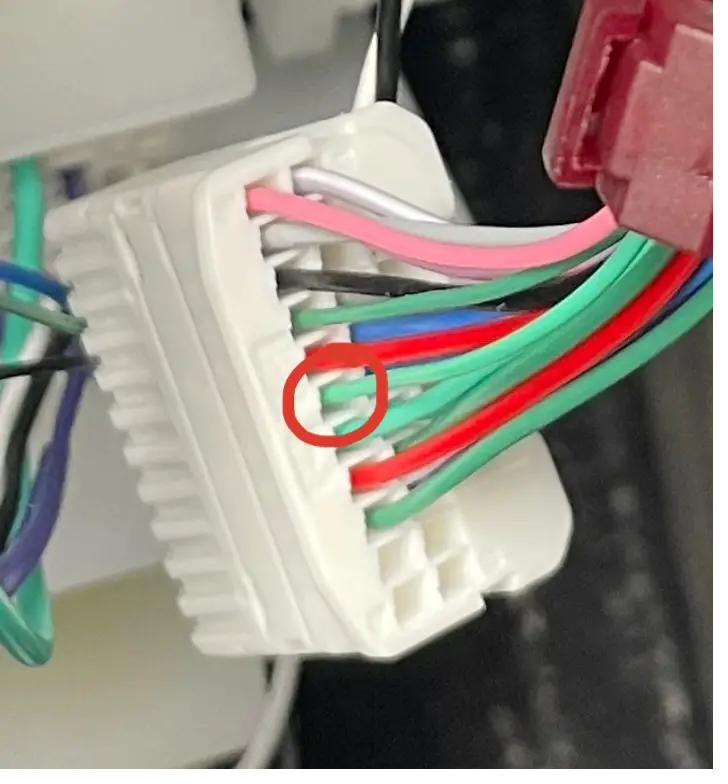
sienna-powerfold-guide/src/images/BC45070C37D3A08A4E5510C035B70BFF.jpg
