StephenRJohns/sienna_camper/sienna-powerfold-guide/src/images/C0A854D9032A4A289A277C63162F84DE.jpeg

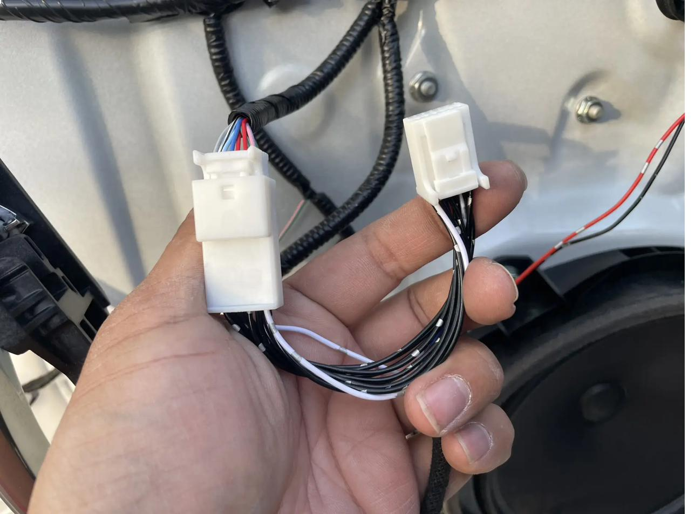
sienna-powerfold-guide/src/images/C0A854D9032A4A289A277C63162F84DE.jpeg
