StephenRJohns/sienna_camper/sienna-powerfold-guide/src/images/DAA77A26F6CF420CB934DBB00E0DE7F7.jpeg

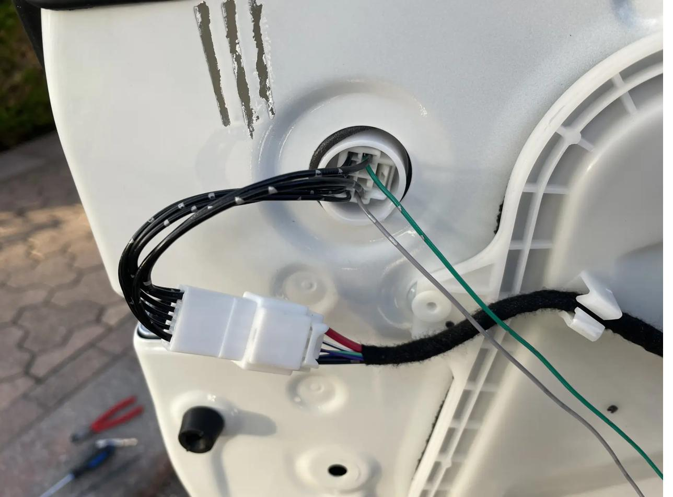
sienna-powerfold-guide/src/images/DAA77A26F6CF420CB934DBB00E0DE7F7.jpeg
