StephenRJohns/sienna_camper/sienna-powerfold-guide/src/images/DBE5E93AE5344C24998313D194DEB392.jpeg

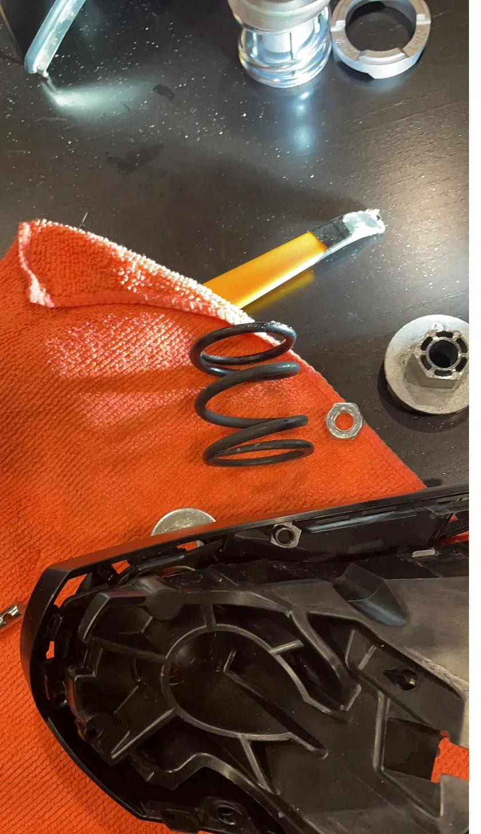
sienna-powerfold-guide/src/images/DBE5E93AE5344C24998313D194DEB392.jpeg
