StephenRJohns/sienna_camper/sienna-powerfold-guide/src/images/F6F9BD38685B4B76A368E62D02BD0ADC.jpeg

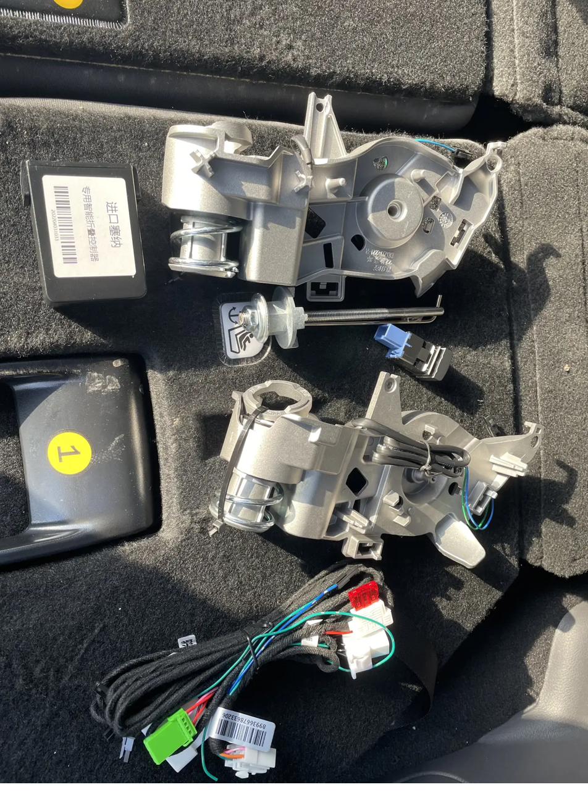
sienna-powerfold-guide/src/images/F6F9BD38685B4B76A368E62D02BD0ADC.jpeg
