StephenRJohns/sienna_camper/sienna-powerfold-guide/src/images/F011A1DB5F6143BB8136ABA405917884.jpeg

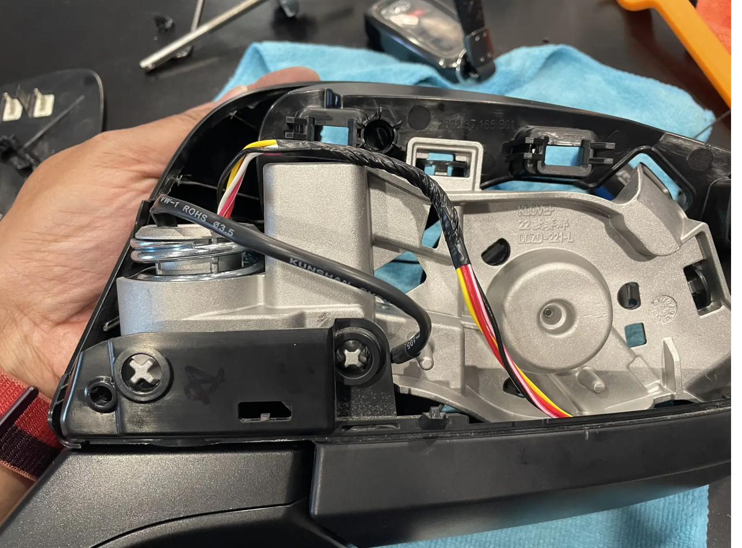
sienna-powerfold-guide/src/images/F011A1DB5F6143BB8136ABA405917884.jpeg
