StephenRJohns/sienna_camper/sienna-powerfold-guide/src/images/Screenshot_from_20260807_154713.png

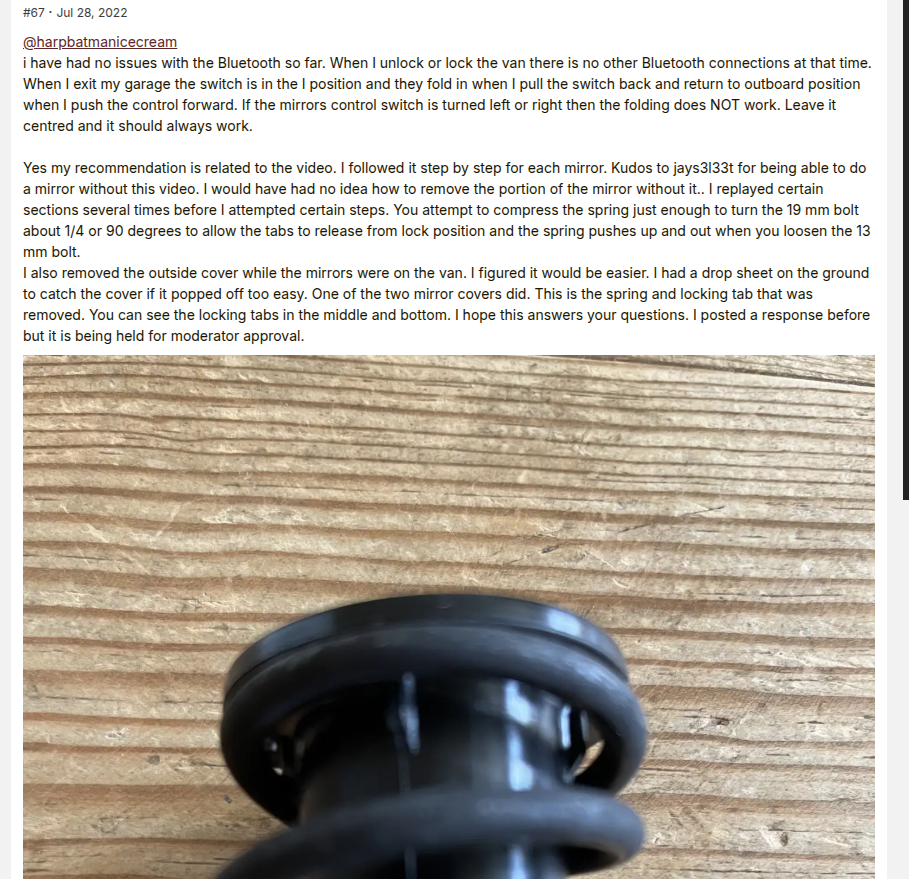
sienna-powerfold-guide/src/images/Screenshot_from_20260807_154713.png
