StephenRJohns/sienna_camper/(commit log)

2026-07-18 Sienna camper build plan: parametric OpenSCAD models, renders, PDF pipeline, and the block-leveling calculator
    [bed_frame_detail.scad, cabinet_door_detail.scad, colors.scad, delta3_wave3_detail.scad, dim_style.scad, electrical_layout_detail.scad, fridge_install_detail.scad, fridge_slide_detail.scad]
2026-07-18 Drop the electric leveling-feet option; leveling is blocks-at-the-wheels plus one-time interior feet
2026-07-18 params: retire the electric-feet mention in the leveling comment
    [params.scad]
2026-07-18 Headboard: enclosed middle-band bed cubby (food above+below); crisper detail-render text; drop low-value 3D isometric views
    [headboard_elevations.scad, headboard_lego.scad, headboard_storage_detail.scad, iso_view.scad, params.scad, platform.scad, rear_view.scad]
2026-07-18 Fix NTC sensor placement (fridge bay at exhaust, not cabinet) in rear view; component-location audit: clarify PS2 rides the slide-out kitchen, refresh stale fan/shelf labels
    [cabinet_door_detail.scad, electrical_layout_detail.scad, fridge_install_detail.scad, panel_c_wall_detail.scad, params.scad, rear_view.scad]
2026-07-18 Add passive cooling vents: low cool-air intake louver in the front wall + low exhaust louver in the cabinet door
    [panel_c_wall_detail.scad]
2026-07-18 Stale-info audit: correct fridge specs to the Rocky 40 manual (40.6lb/60W), fix fridge/kitchen side + coordinate rows, drawer counts, grommet count, cross-refs, weight prose, and cost subtotal
    [panel_c_wall_detail.scad, params.scad]
2026-07-18 Add materials shopping list (interactive, categorized, with product links and totals)
2026-07-18 Shopping list: show full product URLs (copy-paste + print friendly)
2026-07-18 Pantry: adjustable shelf in the 13in bottom bay + marine-galley retention (fiddle lips + lash straps + bins + liner) replacing plain bungee nets
    [headboard_elevations.scad, headboard_lego.scad, headboard_storage_detail.scad, params.scad, platform.scad, rear_view.scad]
2026-07-18 Stale-info audit: fix cam-lever count (8 not 6), bolt->cam-lever cleat wording, adjustable-shelf caption, and the July-18 cost subtotal (142->175)
2026-07-18 Audit round 2: correct grand total to the real BOM sum (~$2,960-3,354), fix headboard weight/grommet-count/coord discrepancies, refresh stale params comments
    [params.scad]
2026-07-18 Drop bottom stabilization frame to the leg bottoms (1in); add found-storage: DELTA 3 drawer tray + WAVE 3 overhead shelf + cabinet bins (dead headroom reclaimed, no structural change)
    [delta3_wave3_detail.scad, params.scad, platform.scad]
2026-07-18 Add Joinery & Fastener guide (Ryobi DBJ50 R-series biscuits): per-component biscuit/screw scheme with biscuit-location measurements, new reference render + BOM
    [joinery_detail.scad]
2026-07-18 Stale-info audit: reconcile build steps with the joinery guide (biscuits not screws), fix bottom-rail 2->1 straggler, Panel A weight, and a grommet-count blurb
2026-07-18 Add printable cut-list shop sheet (grouped by material, check-off boxes, print-optimized)
2026-07-18 Add build sequence / assembly-order page (dependency-ordered phases, checkboxes, progress tracking)
2026-07-18 Add working-sheet appendices (build sequence, shopping list, cut list, leveling calculator) to the plan
2026-07-18 Add design-review feedback page with six drawings (floor plan, side elevations, headboard, stowed/deployed gate views)
    [rear_view_deployed.scad, view_headboard_front.scad, view_side.scad]
2026-07-18 Add design review as PDF (print-fit CSS so drawings fit one page each)
2026-07-18 Add seam draw-latches (clamp modules into one rigid beam) with positioning diagram; fix fridge-wiring diagram to Rocky 40 specs
    [fridge_wiring.scad, params.scad, seam_clamp_detail.scad]
2026-07-18 Block calculator: visual drag-the-bubble RV bar-level input matching the physical level (replaces numeric steppers + low-side toggles)
2026-07-18 Lighter-wood weight swaps (½/⅜ ply + 8 slats, ~25lb off) + Appendix E weight budget/drivability analysis + raceway, material-options & battery-placement notes
    [fridge_slide_detail.scad, headboard_elevations.scad, headboard_storage_detail.scad, kitchen_drawer_detail.scad, panel_c_wall_detail.scad, panel_detail.scad, params.scad, weight_budget.csv]
2026-07-18 Sync companion docs to latest plan: weight swaps in cut/shopping lists, seam-latches in build sequence + design review, updated cost + drawings
2026-07-18 Calculator: add tilting 3/4-view van (side for pitch, rear for roll); correct wheelbase to verified 2026 Sienna 120.5"
2026-07-18 Calculator: redraw the tilt vans as recognizable Sienna minivans (side view for pitch, rear 3/4 for roll)
2026-07-18 Calculator: composite layout — one rear-3/4 Sienna with the roll level on the tailgate and the pitch level on the side, aligned to the vehicle (rotation-aware drag)
2026-07-18 Calculator: replace minivan with a simple 3D box — roll level on the tailgate face, pitch level aligned to the side face
2026-07-18 Calculator: skew the pitch control flush onto the box side face (parallel edges, no overhang); simplify drag mapping
2026-07-18 Calculator: center the pitch control on the side face; move SIDE label fully onto the face
2026-07-18 Calculator: phone optimization — big +/- step buttons per reading for easy control (box + bubbles stay as live display)
2026-07-19 Weight budget: credit the ~120 lb of removed 2nd-row seats; show net (~304 lb) + freed payload
    [weight_budget.csv]
2026-07-19 Swap plywood pantry -> prefab like-it drawer cluster + pot bay (Component 1): update BOM/cost/cut list/weight sheet/Appendix E/layout/renders + cleat-strap hold-down; build ~397 lb, total ~$3,040-3,4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
    [rear_pantry_detail.scad, weight_budget.csv]
2026-07-19 Complete prefab-pantry conversion: purge all headboard/pantry traces from params/model/views/plan/artifacts; delete legacy detail files; re-render everything
    [bed_frame_detail.scad, delta3_wave3_detail.scad, electrical_layout_detail.scad, headboard_elevations.scad, headboard_lego.scad, headboard_storage_detail.scad, joinery_detail.scad, mattress_lego.scad]
2026-07-19 Purge final headboard mentions (comments + prompt doc)
    [params.scad, rear_view_deployed.scad, side_view.scad]
2026-07-19 Final headboard purge (params comment + prompt doc)
    [params.scad]
2026-07-19 Pantry: real IRIS 12"W dims (24.2x14.3x16.8 cluster, 2x2 + 21.8" bay); add 4x Sterilite 28-Qt Panel B totes; update params/renders/plan/weights/artifacts; build ~405 lb, total ~$3,090-3,485
    [params.scad, rear_pantry_detail.scad, weight_budget.csv]
2026-07-19 Kitchen side audit: fix stale left-side comments (kitchen = RIGHT/passenger, fridge = LEFT/driver), clarify JAGAHAHA 'left side' as product variant, add DRIVER/PASSENGER labels to rear views + electr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
    [electrical_layout_detail.scad, params.scad, rear_pantry_detail.scad, rear_view.scad, rear_view_deployed.scad]
2026-07-19 Mirror the electrical-layout top-down so tailgate-at-top puts PASSENGER on page-left (true bird's-eye); add DRIVER/PASSENGER labels to floorplan + fridge-install; clarify Panel C origin as driver-sid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
    [electrical_layout_detail.scad, fridge_install_detail.scad, top_view.scad]
2026-07-19 AC outlets verified (1 front console 1500W + 1 back passenger area): cooktop + Power strip 1 move to the REAR outlet — short cords, zero AC seam connectors; splitter downsized; grommets 10->7; totals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
    [electrical_layout_detail.scad]
2026-07-19 Rear outlet position verified (passenger quarter, ~9.5" up, ~10" fwd of scuff; shared 1500W inverter confirmed): update Section 0/5/7, diagrams, grommet guidance; add 12V-battery-access-panel keep-cl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
    [electrical_layout_detail.scad, fridge_wiring.scad]
2026-07-19 Add Modern Spare kit stowed flat in Panel B at the axle (new render + Component 3 + BOM + weights: build ~437 lb, net ~317; totes 4->2; totals ~$3,300-3,780)
    [params.scad, spare_stow_detail.scad, weight_budget.csv]
2026-07-19 Appendix E + Phase 9: spare-at-axle weights (build ~437, net ~317, loaded ~777, margin ~325-525)
2026-07-19 Spare = RJ-MODINI kit (T155/85R18 steel, 28.5" — closest OE diameter match, $349.95): update render/params/plan/weights (build ~441, net ~321, loaded ~781)/artifacts; totals ~$3,350-3,740
    [params.scad, spare_stow_detail.scad, weight_budget.csv]
2026-07-20 Spare stowage: add install (exploded) + 4-step access diagrams; cradle skid + footman-loop hold-down hardware
    [spare_stow_detail.scad]
2026-07-20 Mark July 2026 purchases across shopping list + plan; swap bought substitutes (Masterwise straps, houya latches, Larbeti levels, UMETRE cookware, Windmill fan); fridge = Rocky V3.0 ordered direct
    [electrical_layout_detail.scad]
2026-07-20 Add leveling-foot engineering drawing (section + exploded + knob top view, as-purchased parts); pad dia 1.375 per Anwenk listing
    [leveling_foot_assembly.scad, params.scad]
2026-07-20 Leveling foot: Anwenk part is a screw-in threaded insert, not a prong T-nut — 3/8 pilot x 7/8 deep (was 1/2 x 3/4), hex collar drawn, text swept
    [leveling_foot_assembly.scad, leveling_foot_detail.scad]
2026-07-20 Drill spec back to maker's 1/2 in hole for the leveler insert (7/16 is the core dia; crests bite wider) x 7/8 deep
    [leveling_foot_assembly.scad, leveling_foot_detail.scad]
2026-07-20 Add jam-nut-vs-collar rule to the leveling-foot drawing + Step 6 caption (collar-jam unscrews when reversed; collar = wrench flat)
    [leveling_foot_assembly.scad]
2026-07-20 Mark July 19 evening batch purchased: straps, brackets, catches, vents, E-track 10-pack, kitchen slide, star knobs; add RESQME
2026-07-20 Full review pass: 52 doc corrections (stale pantry-era text, wrong grommet count/wall holes, 10-vs-8 slats, insert depth, CG 1.1in, module lift weights, purchased-product sync) + 9 diagram fixes (mir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
    [bed_frame_detail.scad, kitchen_drawer_detail.scad, leveling_foot_detail.scad, params.scad, rear_pantry_detail.scad, rear_view.scad, rear_view_deployed.scad, spare_stow_detail.scad]
2026-07-20 Show spare + tool-case stowage on the side-profile and top-down overviews; fix their text collisions; each appendix starts on a new PDF page
    [side_view.scad, top_view.scad]
2026-07-21 Add Appendix F: nighttime van+tent cooling setup with new diagram
    Documents running the WAVE 3 alone (skipping the factory AC) to
    condition the shared van+tent air volume overnight, since the AC's
    sealed-cabin requirement conflicts with the tent's open-tailgate
    connection. Adds a parametric top-down diagram (WAVE 3 position,
    hose routing, DELTA 3 power source, tent sleeve/footprint, airflow).
    [night_cooling_setup_detail.scad, params.scad]
2026-07-21 Add IKEA-style per-component header banners with numbered assembly callouts; convert detail renders to isometric
    - New steps/hardware_icons.scad: parametric iso line-art icon library
    for the accessory lists (screws, brackets, slides, latches, fans,
    leveling foot, grommets, straps, etc.) + accessory_cell layout.
    - New steps/component_headers.scad: one header banner per Section-6
    component (FINISHED COMPONENT hero + ACCESSORY LIST + numbered
    PART LIST), driven by -D comp=N.
    - steps/lego_lib.scad: add part_badge, badge2d, hdr_frame helpers.
    - FINISHED COMPONENT diagrams now carry callouts keyed to their lists:
    numbered (01, 02...) for components with cut parts (1-4, 7-9), and
    letter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
    [component_headers.scad, delta3_wave3_detail.scad, hardware_icons.scad, lego_lib.scad, rear_pantry_detail.scad, seam_clamp_detail.scad, spare_stow_detail.scad]
2026-07-23 Fix fridge slide to side-mount, add full wiring connection points, recess deck for extra headroom
    The fridge slide was drawn as undermount (hardware stacked under the tray),
    which doesn't match the real VADANIA side-mount rails and would have made
    the fridge too tall to clear Panel C's tailgate end rail. Rebuilt the slide
    stack as side-mount (rails flank the tray on steel risers, tray hangs on
    1x3 aprons) across params, the 3D model, and every dependent diagram.
    Documented every wiring connection point (P1-P12) from the DELTA 3 through
    the fuse block, switches, W1209 controller, and both fans, with exact
    terminals/connectors/crimps, so the electrical section is buildable without
    guessing at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
    [cabinet_door_detail.scad, component_headers.scad, delta3_wave3_detail.scad, fridge_install_detail.scad, fridge_slide_detail.scad, fridge_wiring.scad, kitchen_drawer_detail.scad, lego_lib.scad]
2026-07-23 Add drilling, mounting, and corrosion-protection detail for the floor-pan E-track anchors
    Closes gaps in Section 8 for the fridge/kitchen tie-down installation:
    step-drilled hole sizing (pilot through clearance, one size over the
    5/16" bolt), vehicle access (ramps/jack stands) and how to actually
    thread a nut on from underneath when a carriage bolt's square shoulder
    has nothing to bite into in sheet metal, a warranty note on what
    drilling the floor pan does and doesn't put at risk, and a full
    rustproofing sequence (degrease, cold-galvanize the bare cut edge,
    butyl sealant, undercoating) plus blue threadlocker as a belt-and-
    suspenders backup to the nylon lock nuts.
2026-07-23 Flag the rear floor as unverified for the E-track anchors; add the F1-F7 check-before-drilling list
    The Sienna's rearmost stretch — exactly where Panel C and all 8 floor
    anchors live — is the 3rd-row stowage area: a deep well the folded
    seatbacks drop into, so much of that "floor" may be seatback or liner
    over a void rather than drillable structural pan. Nothing in the plan
    had ever verified this.
    Section 0 gains a rear-floor checklist (F1-F7): map seatback vs well vs
    solid pan across Panel C's footprint, locate the well edges/depth
    against the hatch datum, check each of the 8 anchor positions and the
    leg/kitchen bearing spots specifically, determine whether exposing pan
    requires removi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
2026-07-27 Replace drilled E-track anchors with a no-drill striker-strapped anchor board
    Owner ruled out drilling the vehicle. Section 8's 8 through-bolted floor anchors (16 holes, drill/rustproof/warranty procedure) are replaced by a 3/4-in ply anchor board strapped to the 3 crash-rated 3rd-row striker loops: riser angles and kitchen L-track bolt to the board, two steel tongues butt the striker-row step for the forward load path, 3 ratchet straps take rearward/lift. Repurposes the F1-F7 floor survey to feed the board's geometry (striker position, bearing step, well blocking), folds the Rocky fridge manual's one-end vent layout and clearance specs into measurement row 4 and Section 2, and updates Compo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
    [weight_budget.csv]
2026-07-27 Draw the no-drill anchor board in the renders (mat, ply strips, bridge, tongues, striker straps)
    The detail diagrams and 3D views still showed the superseded E-track floor anchors. fridge_install_detail now draws the hatched board strips, kitchen L-track + stud D-rings, full-width bridge, 2 bearing tongues, and the 3 striker straps; fridge_slide_detail shows the mat + ply strip under the raised rail with T-nut bolts; platform.scad replaces anchor footprints with board strips; comp-7 header lists the new hardware. Rails ride ~0.85in higher on the board (new params + apron-overlap assert) — the tray keeps its 0.5in hang, so the plan text's rail-height compensation is corrected to match in Se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
    [component_headers.scad, fridge_install_detail.scad, fridge_slide_detail.scad, params.scad, platform.scad]
2026-07-27 Bolt the anchor board to the 2nd-row floor rails; cut the cabinet door for an open utility bay
    Forward restraint is now a positive steel-to-steel connection: the board's 2 flat-bar tongues bolt/clamp to the rear ends of the Sienna's 2nd-row long-slide floor rails (exposed once the seat carriages park forward) with the striker-row step kept as the bearing fallback; new F8 survey row + photo capture the rail-end hardware. The hinged, louvered cabinet door between the fridge and kitchen is deleted as pointless — the gap becomes an open utility bay (exhaust air exits straight out, switches reached by hand, bins velcroed down), removing the door, hinges, catch, and exhaust louver from Component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
    [component_headers.scad, electrical_layout_detail.scad, fridge_install_detail.scad, fridge_slide_detail.scad, fridge_wiring.scad, joinery_detail.scad, kitchen_drawer_detail.scad, panel_c_wall_detail.scad]
2026-07-27 Draw the rail platform in the side/rear/kitchen-drawer views; add its overhead detail to the floorplan section
    New anchor_platform_overhead.scad: plan view of the whole no-drill securing system — board, tongues bolted to the 2nd-row floor rails' rear ends, striker straps — placed under the PDF's Overhead Floorplan heading ahead of the whole-van top view (md carries its own copy, deduped at PDF build). Side profile gains the board band, tongue, rail end and bolt at the floor; rear view draws the board strips end-on with a new legend item; kitchen-drawer rear section shows the strips flanking the unit.
    [anchor_platform_overhead.scad, kitchen_drawer_detail.scad, rear_view.scad, side_view.scad]
2026-07-27 Make the anchor-platform overhead diagram self-explanatory
    Replace the cramped side notes column with short wrapped right-margin callouts naming each element (floor rail, rail rear end, striker loop, ratchet strap, D-ring, bridge, edge strip), wrap the Panel B caption, label the tongues and strips in-drawing, mark the bare-floor zones under the tray and kitchen, and add a READ ME block spelling out what bolts to the rails, what hooks the strikers, and that the board is a plywood skeleton, not a full false floor. Section 8 gains the same skeleton-not-floor clarification. PDF rebuilt.
    [anchor_platform_overhead.scad]
2026-07-27 Add the anchor-board assembly detail sheet; fix pentagon-rendered D-ring icons
    New anchor_board_assembly.scad, a 4-view sheet placed after the overhead platform diagram: V1 dimensioned top view of the bare plywood assembly (bridge + strips, tongue dado lap joints, L-track, D-rings, riser bolt patterns); V2 4x side section of the fridge-side stack (mat/ply/T-nut/riser/rail with the tray hanging over bare floor); V3 kitchen criss-cross strap elevation into the stud D-rings; V4 board-to-van side view (tongue to the rail end, striker strap, step fallback, Panel B's notched rail). The 5-sided black icons in the overhead/install diagrams were D-rings and bolts rendered as pentagons by OpenSCAD's d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
    [anchor_board_assembly.scad, anchor_platform_overhead.scad, fridge_install_detail.scad]
2026-07-27 Add a symbols legend to the assembly sheet and an IKEA-style banner for the anchor board
    The assembly sheet gains a SYMBOLS legend decoding every mark (ply hatch, mat band, tongue bar, dashed hidden parts, D-ring, T-nut bolt, L-track, strap). New comp-11 header banner in the Section-6 format — finished-component iso, lettered accessory list (L-track, stud D-rings, straps, bolts+T-nuts, mat, threadlocker, F8 rail-end bolts), numbered part list (bridge, 3 strips, tongues) — embedded at the top of the Anchor Board renders subsection. PDF rebuilt.
    [anchor_board_assembly.scad, component_headers.scad]
2026-07-27 Specify how the anchor board's ply pieces join; add the V5 joint diagram
    The strip-to-bridge connection was undrawn and unspecified. Now: prefer cutting the whole H/comb as ONE piece from the 3/4in sheet's spare (46x36 envelope, zero joints); fallback for smaller stock is a 6in half-lap per strip — 3/8in rabbet in the bridge's underside meeting a matching rabbet in the strip's top, glued full-face + 4x #8x3/4 screws — with the note that the laps carry rearward strap tension. New V5 view on the assembly sheet shows the one-piece sheet layout and the lap section; Section 8, the BOM line, install step 1, and the comp-11 banner (lap screws + glue accessories) all updated; the 'four strips' t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
    [anchor_board_assembly.scad, component_headers.scad]
2026-07-31 Cut the anchor board as one piece; add an accessory install map
    The anchor board was a full-width bridge plus three strips joined with
    glued and screwed 6" half-laps. It is now a single 46"x33" comb cut from
    one blank, so nothing on the board joins ply to ply — the 12 lap screws
    and the wood glue are gone from the BOM, and every fastener left holds
    hardware to the ply.
    It costs no extra stock. The 3/4" sheet carries only Panel C's deck plus
    some ripped cleats, leaving a contiguous 48"x60" spare, and the comb's
    two gaps fall out as usable 16.85"x27" and 20.5"x27" offcuts.
    Drawings: V1, the platform overhead, the fridge-install overhead and the
    banner hero all trace the board as a single o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
    [anchor_board_assembly.scad, anchor_board_install.scad, anchor_platform_overhead.scad, component_headers.scad, fridge_install_detail.scad, lego_lib.scad, params.scad, side_view.scad]
2026-07-31 Add a Diagram column of overhead key maps to the F1-F8 floor survey
    Each row of the rear-floor survey table now carries a thumbnail showing
    what to measure, located against the vehicle floorplan. All eight are the
    same overhead of the zone — tailgate at the bottom as the Y=0 datum,
    Panel C's footprint, the stowage well, the striker row and its 3 loops,
    and the 2nd-row rails running forward — with only that row's measurement
    picked out in red. Reading them as a set is the point, so there is no
    text inside them at ~1in wide; a legend above the table decodes the
    symbols once, including the section-mark pair that means a dimension is a
    depth or height rather than something you take off the p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
    [floor_survey_keys.scad]
2026-07-31 Split the F1-F8 floor survey into sections with whole-vehicle plans
    The survey was a table whose Diagram column held thumbnails of the cargo
    zone alone. It is now one section per measurement (F1-F8 as h4 headings,
    each with Measure / Feeds / Current assumption / Your finding), and each
    carries a full page-width plan of the WHOLE Sienna, so what you are being
    asked to measure is located against the actual vehicle.
    floor_survey_keys.scad is rewritten around a shared van_base(): body
    outline, front seats, the empty 2nd-row bay with its long-slide floor
    rails, the folded 3rd row over its stowage well, the sliding-door
    openings and Panel C's footprint — front at the left, tailgate at the
    right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
    [floor_survey_keys.scad]
2026-07-31 Give each survey section a blank finding line per lettered measurement
    F2 asks for two dimensions but had one blank to write on, and most other
    sections had the same mismatch. Every lettered item in a drawing now has
    its own finding line, labelled with that tag (F2a, F2b, ...) and a short
    reminder of what it is, so there is somewhere to write down each thing
    you were asked to measure.
    Sections whose drawings only tagged part of what they ask about now tag
    the rest: F4c (each loop's inside clearance), F5a/F5b (the leg pads vs
    the kitchen footprint), F6a/F6b (fold-or-remove vs the wiring and
    seat-mount bolts), and F7a/F7b (the step face in plan vs its height in
    section, which also renames tha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
    [floor_survey_keys.scad]
2026-07-31 Share one Sienna plan outline across the floorplan and survey drawings
    The Overhead Floorplan drew its own crude van silhouette (a rounded blob
    with wheel blocks) while the new Section 0 survey plans drew a much better
    one. New van_plan.scad holds a single copy — body, hood/windshield, glass
    band, wheels, front seats with the steering wheel, sliding-door openings
    and the closed hatch — and both drawings now place that same geometry, so
    every plan view in the document is the same vehicle.
    The shared module is GEOMETRY ONLY, on purpose: the survey plans run
    front-at-left and the floorplan runs front-at-top, and a module carrying
    labels would rotate them with it. Each caller transforms the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
    [floor_survey_keys.scad, top_view.scad, van_plan.scad]
2026-07-31 Split the van measurements into sections with whole-vehicle plans
    Same treatment the F1-F8 rear-floor survey just got: the "measure the
    van" checklist was a 17-row table, and a table can name a dimension but
    can't show you where on the vehicle to put the tape. Each measurement is
    now its own section (V1-V10) with a full page-width plan of the Sienna,
    that measurement alone drawn in red and tagged, and a blank line per tag.
    New van_measure_keys.scad, driven by -D key=1..10, built on the shared
    van_plan.scad so these are the same vehicle as the survey plans and the
    platform floorplan. Several of these aren't plan dimensions at all —
    interior height, the gate opening, wall-to-wall width up a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
    [van_measure_keys.scad]
2026-07-31 Factor the shared 2D drafting primitives into sheet2d.scad
    Clears the duplication noted in van_measure_keys.scad's header. The
    outline/dash/text/dimension/badge/inset helpers existed in three copies —
    twice verbatim in the two sheet files, and a third time in van_plan.scad
    under a vp_ prefix. There is now one copy.
    sheet2d.scad is included by van_plan.scad, and the sheets include
    van_plan.scad, so they get it transitively — OpenSCAD's `include` pastes
    the file, so including it in both places would redefine every module and
    warn. That ordering is documented at the top of each file.
    Sheet-layout-dependent helpers deliberately stay local: callout() anchors
    to its own sheet's CO_X/CO_Y ban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
    [floor_survey_keys.scad, sheet2d.scad, van_measure_keys.scad, van_plan.scad]
2026-08-01 Record the Aug 1 2026 van survey and cut the bed platform to fit
    The Section 0 V1-V10 / F1-F8 survey is done (owner, Aug 1 2026, 2nd row
    out and 3rd row folded as it sits in camper mode). Every finding line is
    filled in, params.scad carries the measured values, and the whole plan is
    propagated to match. Four measurements moved the design:
    V1 length 96 -> 93.75 Panel C absorbs the 0.25" net loss (36 ->
    35.75): Panels A and B are asserted equal
    and their sum IS bed_frame_length, so
    neither can be shaved.
    V3 height 44 -> 42 Sitting headroom 21.5 -> 19.5"; a 3rd
    pantry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
    [bed_frame_detail.scad, params.scad, van_measure_keys.scad]
2026-08-01 Correct the wall-taper direction in the V7 mattress-fit note
    The measurements show the cabin NARROWING with height at the sleeping
    plane — 50in at ~18.5in up, 49.5in at ~22.5in — so the pinch lands on
    the mattress's top outer edges, not its base. Two comments claimed the
    walls kept flaring outward above the deck, which inverts the reasoning
    for why the 50in foam wedges in.
    [params.scad]
2026-08-01 Split Panel B's bed top into two lift-out halves; move the survey to Appendix A
    Three owner decisions this round.
    1. SIDE DOOR APERTURE MEASURED: 35 x 45in. The 50x58in first written on
    the V8 sheet was the door PANEL's own outside dimensions, not the
    opening. Separately V8c stands: the door parks 6in short of the
    aperture's forward edge, so only 29in is ever CLEAR. New param
    side_door_clear_width holds that 29in and the reach check runs off it;
    side_door_opening_width/_height now hold the real aperture. The
    aperture sits over Panel A, so Panel B has no side access at all.
    2. PANEL B'S BED TOP IS NOW TWO LIFT-OUT HALVES, replacing the hinged
    hatch added earlier this se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
    [bed_frame_detail.scad, floor_survey_keys.scad, params.scad, van_measure_keys.scad, weight_budget.csv]
2026-08-01 Fix Panel A's top down, detail the tongue->rail connection, add store-cut plan
    Four things.
    1. PANEL A'S BED SECTION IS NOW SCREWED DOWN, not lift-out (owner: it
    never needed to come out — both its bays are reached through the side
    doors). It is a real simplification: the section becomes a screwed-down
    diaphragm across Panel A's rails, putting back some of the torsional
    stiffness lost when A and B gave up their plywood tops; it is the
    fore-aft datum the two loose Panel B halves register against; and it
    cannot rattle, so it needs no anti-rattle pads. Only 2 of the 3 bed
    pieces are loose now. Trade: Panel A is side-door-access only.
    2. TONGUE -> RAIL CONNECTION DETAILE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
    [delta3_wave3_detail.scad, params.scad, rail_tongue_detail.scad, sheet_cut_layout.scad]
2026-08-01 Widen the kitchen drawer to an 18in box, and guard its width
    kdrawer_span 17 -> 19, so the box goes 16 -> 18in and the clear interior
    15 -> 17in. The assembly had been sitting 2in shy of the kitchen unit's
    inboard edge for no reason: cheeks + span came to 18in inside a 20in
    footprint. Moving the inner cheek flush with that edge is free — same
    1/2in sheet, same 24in slides (slide length is fore-aft, not width),
    +0.8lb.
    19in is the hard ceiling, from two directions. Outboard, the outer cheek
    already butts the side rail's inner face, which is also the only lateral
    screw in the assembly. Inboard of the kitchen is the utility bay, which
    measures 3.28in against a control-panel enclosure needing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
    [params.scad, sheet_cut_layout.scad, weight_budget.csv]
2026-08-01 Close out the rail measurements; the plastic housing needs a crush tube
    MEASURED (owner, Aug 2026), replacing four estimates:
    F8b rail spacing 17 -> 17.5 (was scaled off a photo)
    slot width ? -> 0.75 3/4in is the STANDARD woodworking
    T-track size, so stock 1/4"-20
    T-bolts fit. Case A is viable.
    metal track top 0.75 -> 0.5
    plastic housing - -> 1.0 NEW dimension, and the problem below
    end cap fastener ? -> one flush slotted (flat-blade) fastener in
    a round recess. Worth trying a 90deg
    turn first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
    [params.scad, rail_tongue_detail.scad]
2026-08-01 Measure the side door's position and the rear-corner vents — no placeholders left
    side_door_y0 was the last genuinely unmeasured number in the model, a
    placeholder guess of 0 that had never been checked. MEASURED (owner, Aug
    2026): the front seatback is essentially even with the door opening at
    build height — if anything the seatback intrudes about 1/4in INTO the
    opening. So Y=0 is right, and the old guess turns out to have been
    correct; it is now a measurement.
    That matters more than the number suggests, because it is what confirms
    two design decisions that had been resting on the placeholder:
    - the 29in clear gap (V8c) starting at Y=0 spans Panel A's 29in
    EXACTLY, so Panel A is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
    [params.scad]
2026-08-01 Make the anchor-board install map legible; move its prose into the document
    The map's labels were rendering at roughly 4pt on paper, and the cause was
    structural rather than a font size: the sheet carried the A-G descriptions
    and the 7-step build order as two more columns of prose, which took it to
    ~130 units wide. A rendered figure is scaled to the page, so legibility is
    just page_width / sheet_width — at that width nothing on the sheet could
    be readable no matter what size it was set in.
    So the prose is gone from the drawing and is document text now: an A-G
    accessory table and a numbered build-order list in Section 8, rendering at
    the document's own 9-10.5pt, selectable and searchable.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
    [anchor_board_install.scad]
2026-08-01 Make the forward load path a butt joint; rule out the slid-in nut bar
    WHY THE CHANGE. The rail's slot runs FORE-AFT — the same direction as
    the load, because a seat track exists for a carriage to slide along it.
    So anything sitting in the slot (T-bolt, channel nut, slid-in bar)
    resists forward load by FRICTION only. Order of magnitude: a 1/4-20
    torqued sensibly gives ~1,200lb clamp, steel-on-steel mu ~0.18, so
    ~215lb of fore-aft grip per bolt — ~430lb across two tongues against a
    ~155lb loaded board. Fine for real braking, nowhere near a crash. That
    had been the plan's forward load path and it was the weakest link in it.
    The board sits BEHIND the rail ends (33in vs 42in), so forward loa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
    [params.scad, rail_tongue_detail.scad]
2026-08-01 Use the end cap's 1/4in hole as a PIN socket, not a bolt hole
    Two owner findings this round, and together they finish the forward
    connection.
    1. THE STEEL END CAP IS STRUCTURAL. So the lug bears directly on it
    rather than having to reach past a stamped cover to the rail's body —
    a steel-to-steel bearing joint into a structural member of the
    vehicle's own seat anchorage. The 1.0 sq in bearing figure is taken on
    the 0.5in metal-track height and is conservative if the cap stands
    taller. One thing left to eyeball while fitting: that the cap is
    captive to the rail (integral/welded/riveted) rather than clipped,
    since the whole forward load crosses that attachment.
    2. THE C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
    [params.scad, rail_tongue_detail.scad]
2026-08-01 The cap hole's height deletes the lug — pin goes through the bar itself
    MEASURED (owner, Aug 2026): the cap's 1/4in hole is centred 1in above the
    floor pan and centred on the rail laterally.
    That height is the whole story. The tongue's underside sits at 0.85in and
    its top at 1.04in, so the bar's own mid-thickness is at 0.94in — 0.06in
    from the hole's centre. So the pin goes straight THROUGH THE TONGUE'S
    FORWARD END, horizontally, in line with the bar: drill one hole in the end
    of the flat bar and fit a 1/4in bolt as the pin, nutted on the tongue's
    own accessible face with its plain end protruding. Take up the 0.06in with
    a slightly undersize pin and a lead chamfer.
    The downturned lug i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
    [params.scad, rail_tongue_detail.scad]
2026-08-01 Flag the tongue pin's orientation as unresolved — do not build this joint yet
    The committed design assumes the cap's 1/4in hole sits in a REARWARD-FACING
    vertical face, so a pin projecting forward out of the tongue slides in
    horizontally and the tongue's end face bears flat on the cap.
    The owner's later note does not match that: the hole is "past the end of
    the rail, so vertically it is above it, but not directly over it", which
    reads as a FLAT TAB lying rearward of the rail's end. If that is the real
    geometry then the pin is VERTICAL rather than horizontal, the tongue rests
    ON the tab instead of butting anything (so the 0.06in alignment argument is
    the wrong calculation), and there may b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
    [params.scad, rail_tongue_detail.scad]
2026-08-01 Resolve the rail joint: the cap is an open-rear saddle, so the pin is vertical
    RESOLVED from two photos (owner, Aug 2026), and it clears the DO-NOT-BUILD
    flag. The steel end cap is a U/saddle stamping straddling the rail's end: a
    flat TOP face at 1.0in carrying the single 1/4in hole (the two oblong marks
    either side of it are closed stiffening dimples, not usable), two vertical
    SIDE SKIRTS, and an OPEN REAR between them.
    Three consequences, all forced by that geometry:
    * THE PIN IS VERTICAL — down through the tongue into the hole in the
    cap's top face. Not the horizontal pin the previous revision assumed.
    * THERE IS NO BEARING FACE. The rear is open and its edge is a rolled
    h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
    [params.scad, rail_tongue_detail.scad]
2026-08-01 Make the rail-joint sheet legible, and cut the prose it had outgrown
    THE SHEET. Same root cause as the anchor-board map: legibility of a figure
    is text_size x (page_width / sheet_width), and this sheet had grown to 200
    units wide carrying full reasoning in three note columns, so it printed at
    about 5pt. Rebuilt at 140x170 with SHORT labels only — the reasoning was
    already in Section 8's own text at 9-10.5pt, searchable — and it now lands
    near 9pt. Every label that crossed a border or overprinted a neighbour is
    fixed: the header split to two lines, the two long note lines split, the
    band-3 title lifted off the box tops, the pin/cap/rail labels separated.
    There is a note in the file record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
    [rail_tongue_detail.scad]
2026-08-01 Sweep the plan for contradictions the later revisions left behind
    Audited the whole document against every value this session superseded,
    by grepping for the STALE form of each one and reading the hits. Twenty
    were real — text a later change invalidated but never replaced:
    * PANEL A'S SECTION was still called a "lift-out piece" in five places
    (the render caption, the cut list, params.scad, weight_budget.py, the
    bed-frame drawing's own header) after it was fixed down. It is three
    pieces, two of them loose.
    * ACCESSORY G still described the dead butt joint and downturned lug as
    the forward load path, two revisions after the vertical pin replaced
    them.
    * THE REAR PA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
    [bed_frame_detail.scad, params.scad, weight_budget.csv]
2026-08-02 Rework the bed-platform and joinery sheets for legibility
    First two off the audit list, both by the same three moves: prose out of
    the drawing into document text, remaining labels sized for the page, and
    the --viewall padding trimmed.
    bed-frame-detail 160x71 -> 95x70 3.7pt median -> 10.9pt 0/1 under 7pt
    joinery-detail 102x65 -> 80x61 4.7pt median -> 11.7pt 0/7 under 7pt
    BED PLATFORM: the four caption lines and the six-row parts list came off
    the sheet and became a keyed markdown table under the figure. With only
    the numbered badges left, they could be sized for the page (1.3 -> 2.0),
    which is what takes it from 7pt to 11. The dead side_list module went too.
    JOINERY: its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
    [bed_frame_detail.scad, joinery_detail.scad]
2026-08-02 Rework the remaining 21 drawing sheets for legibility — 0 of 23 now under 7pt
    Finishes the audit list. Median printed text size across all 23 rendered
    sheets, before and after this session:
    under 7pt median 21 of 23 -> 0 of 23
    worst sheet 3.6pt -> 7.2pt
    median of medians ~4.7pt -> ~9.0pt
    The lever throughout is that a figure is scaled to the page, so its printed
    text height is size x (page_dimension / sheet_dimension). Measured, a long
    prose sentence was 48-97% of each sheet's width — which is why the labels
    that mattered were at 3-6pt. So: prose out of the drawing and into the
    document, remaining labels sized for the page, --viewall padding trimmed.
    153 pros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
    [anchor_board_assembly.scad, anchor_platform_overhead.scad, cabinet_door_detail.scad, electrical_layout_detail.scad, fridge_install_detail.scad, fridge_slide_detail.scad, fridge_wiring.scad, jig_detail.scad]
2026-08-02 Fix collisions my batch legibility pass introduced on three sheets
    Flipping through the rendered figures found that scaling text up is wrong
    wherever the text lives INSIDE fixed geometry, and that my single-line
    filter cut some multi-line paragraphs in half.
    FRIDGE WIRING was the worst. Its labels sit inside fixed-size boxes, so a
    x2.4 scale simply overflowed every one of them, and the box titles were
    unreadable on top of their own borders. Fixed properly rather than by
    backing the scale off: the 27 detail lines inside the boxes and the 12
    P1-P12 descriptions are now a markdown connection table (Section 5), each
    box keeps one title, and the label default came down to a size that fits.
    The o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
    [anchor_board_assembly.scad, fridge_slide_detail.scad, fridge_wiring.scad, seam_clamp_detail.scad]
2026-08-02 Re-lay out the Panel C wall: three openings were overlapping each other
    The visual pass found this wall was not buildable as drawn. In a 46x17
    sheet of 3/8in ply it had four openings, and three of them collided:
    - the upper cord grommet was drilled INSIDE the intake louver's
    cut-out (louver x 2.0-9.0 / z 3.75-6.25, grommet at 3, 5.5);
    - the lower grommet's bottom edge landed on the bottom rail's top
    face, which backs the wall there (the comment claimed the rail
    topped out at 3.5in; bottom_rail_z + frame_rail_sz is 2.5);
    - 0.18in of ply separated the louver's top edge from the 4.75in fan
    hole.
    The louver now sits squarely under the fan on the fan's centerline,
    widened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
    [electrical_layout_detail.scad, kitchen_drawer_detail.scad, panel_c_wall_detail.scad, params.scad]
2026-08-02 Make the fridge-install markers readable and cut its 3pt side list
    This sheet carried a 10-row, 3-line component list printed beside the
    plan. Its longest line was 180 characters, which stretched the sheet to
    ~160 units wide against a 46in-wide plan; printed text height is
    size x (page_width / sheet_width), so every label on it -- the
    coordinates it existed to convey included -- came out near 3pt. The list
    is now a table in the document under the figure, keyed to the markers.
    All ten markers were also unreadable for a different reason: a white
    numeral centred inside a filled circle. OpenSCAD merges TOUCHING 2D
    shapes into one polygon set and paints them a single colour, so each
    marker rende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
    [fridge_install_detail.scad, fridge_slide_detail.scad]
2026-08-02 Fix the rear views: a mis-keyed marker, ghosted numerals, 4pt labels
    rear-view had a real error. Marker 2 keys the KITCHEN UNIT but sat at
    x=-20, on the DRIVER side, inside the fridge bay -- the kitchen moved to
    the passenger side and the marker did not follow. Moved onto the unit it
    names.
    Both sheets had markers whose numerals were invisible: a white numeral
    centred in a filled circle merges with it, because OpenSCAD unions
    TOUCHING 2D shapes and paints the result one colour. Every marker read as
    an anonymous coloured blob, which on a sheet whose entire key is
    numbered is the whole content. Numerals now sit beside their icons.
    The same rule explains a grey-on-grey deck caption on the depl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
    [night_cooling_setup_detail.scad, rear_view.scad, rear_view_deployed.scad, spare_stow_detail.scad]
2026-08-02 Put three orphaned renders into the document; fix an UNVERIFIED that was measured
    render.sh builds rear-view-deployed, side-driver and side-passenger on
    every run, but nothing referenced them, so they never reached the PDF at
    all. The deployed rear view now follows the stowed one, and the two side
    elevations follow that -- they are what show that the side doors reach
    Panel A but not Panel B, which is the reason Panel B is top-loaded.
    The side elevations then needed the same treatment as the rest: sixteen
    labels set between 0.85 and 1.4 on a 94x57 sheet, i.e. 4.7-7.7pt on
    paper. Raised to 1.4-1.6 with the sub-lines respaced.
    One of those labels read "35in sliding-door opening (UNVERIFIED
    po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
    [view_side.scad]
2026-08-02 Respace panel_detail, fix a survey-plan collision, sweep the Section 0 renames
    panel_detail (all three panels): the batch legibility pass scaled the
    text sizes but not the y-steps between lines, so every heading sat on
    its own description and each 3-line component row ran together. Steps
    widened to match the text, and the left-margin hole insets shortened --
    their lines were running right across the isometric frame in the middle
    of the sheet. The full instructions for both hole details are now in the
    document under the three figures, where there is room for them.
    Marker numerals here had the same white-numeral-in-a-filled-circle
    problem as the other sheets; moved beside their swatches.
    flo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
    [anchor_board_assembly.scad, anchor_platform_overhead.scad, dim_style.scad, electrical_layout_detail.scad, floor_survey_keys.scad, fridge_install_detail.scad, measurement_fridge_kitchen.scad, measurement_van.scad]
2026-08-02 Re-lay the electrical layout: 14-row legend out, insets beside the plan
    The legends longest row was 126 characters, which set this sheet at 158
    units wide; printed text height is size x (page_width / sheet_width), so
    the legend rows themselves came out near 6pt. It is a table in the
    document under the figure now, keyed to markers 1-14.
    With it gone the sheet was 82 x 179 -- so tall and narrow that the page
    fitted it by HEIGHT and it used barely a third of the available width,
    which is what actually set the printed text size. The control-cluster
    elevation and the fan detail now sit BESIDE the van plan rather than
    stacked under it: 139 x 114, close to the pages own proportions, filling
    the fu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
    [electrical_layout_detail.scad]
2026-08-02 Kitchen unit MEASURED: 20.5 x 11.55 x 25-13/16, and it has strap notches
    Owner measured the physical unit (Aug 2 2026), replacing the listing
    figures this layout was built on:
    width 20 -> 20.5
    height 11.8 -> 11.55 (the drawer above gains that clearance)
    length 26 -> 25.8125 (25-13/16)
    The photos also settle the hold-down. The box has NOTCHES routed into its
    top edges, and the makers assembly video shows a cam strap seated IN one,
    running around the box -- that is the units own designed load path, and a
    strap that sits down in a notch cannot slide along the box. It supersedes
    Section 8s kitchen tie-down, which criss-crossed 4 straps diagonally over
    a top assumed to be smooth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
    [floor_survey_keys.scad, params.scad, van_measure_keys.scad]
2026-08-03 Stop trim_render.py flattening the survey plans onto black
    All 18 survey and van-measurement sheets were printing as white-on-black
    negatives in the PDF. My own regression, from when I added the trim step
    and pointed it at these files.
    The pipeline is: OpenSCAD renders them on cream ->
    make_bg_transparent.py alpha-cuts the cream -> normalize_survey_keys.py
    re-crops on the alpha channel to force one common scale -> trim_render.py.
    That last step opened every file with an unconditional .convert("RGB"),
    which composites transparency onto BLACK, and then sampled the corner
    pixel as "the background colour" -- by then black -- so it cropped to the
    wrong thing as well.
    trim_render.py now checks f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
2026-08-03 Kitchen hold-down: 2 notch-seated straps, and the control box comes out
    HOLD-DOWN. The unit has FOUR notches routed at its four TOP CORNERS and
    FOUR D-rings, two of each per face (owner, Aug 2 2026). So each strap
    crosses the top edge at two notches, one per side, and cannot slide along
    the box. That means TWO straps -- one over the front face, one over the
    back -- not the four criss-crossed diagonally that the plan carried. The
    criss-cross only existed to fight sliding on a top assumed to be smooth;
    the notches do that job better.
    Updated the accessory table, the anchor-board V3 elevation (redrawn: one
    straight up-over-down path with the notches marked, since front and back
    straps superimp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
    [anchor_board_assembly.scad, electrical_layout_detail.scad, kitchen_drawer_detail.scad, params.scad, platform.scad]
2026-08-03 Label the apron on V2 and dimension the stack-up the open issue is about
    The owner asked to see the apron question as a diagram. The section that
    answers it already existed -- anchor-board V2, a 4x-scale cut through one
    rail line -- but the apron had NO label on it. The label had gone to the
    document with the prose, which left the one part the section exists to
    locate as an unlabelled brown rectangle. That is why the drawing could not
    answer the question.
    V2 now:
    - names all five parts in a leadered column to the right, in the same
    top-to-bottom order as the parts. Labelled in place they sat on each
    other and on the rail outline -- five parts in a 3.5in-wide section.
    - dimensio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
    [anchor_board_assembly.scad]
2026-08-03 Correct the apron margin and write out Panel C width chain: bay is 1.28in
    Owner confirmed the cross-section order from the V2 section (PDF p.7):
    Z-R-A-A-R-Z -- riser, rail, apron, [tray/fridge], apron, rail, riser. The
    rail stack really is outboard of the apron on BOTH sides, which is what
    the file comment claimed and what the drawing shows.
    So fridge_slide_margin goes 0.5 -> 0.75: what sits in it is the 1x3 apron,
    and a 1x3 is 0.75in thick. The slides moving member screws to the apron
    and the aprons top edge is the fridges anti-shift lip, so it cannot be
    anywhere else.
    Replaced the single-term utility-bay assert with an EXPLICIT width chain,
    term by term, because this budget had been wron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
    [panel_c_wall_detail.scad, params.scad]
2026-08-03 Delete the last of the utility-cabinet door
    The door itself was cut from the design a while back -- it was trapping the
    exhaust air it existed to vent, and it slowed down reaching the switches.
    Every mention of it in the document was already historical and the BOM had
    already dropped its louver. But the source was still on disk and still
    carrying dimensions, and the bay it hung on is 1.28in wide now, past any
    useful door. Owner asked to finish the removal.
    Removed:
    - cabinet_door_detail.scad, a full 3D drawing of a door that does not
    exist. render.sh had a note explaining it stayed on disk unrendered.
    - cabinet_vent_w/h/z from params.scad -- the doors low exhaust louver,
    referen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
    [cabinet_door_detail.scad, params.scad, rear_view.scad, rear_view_deployed.scad]
2026-08-03 Move the control cluster to Panel Cs front wall; the last open issue closes
    The utility bay was only a problem because the cluster had to fit in it.
    Owner said move it, anywhere with room.
    There is no room inside Panel Cs void. Measured the candidate pockets:
    over the fridge stack 1.09in, over the kitchen under the drawer 0.5in,
    over the drawer under the deck 1.2in, and the bay itself 1.28in. None
    takes a 2.8in-deep cluster.
    The front wall is the one surface with real space -- 46 x 17in carrying
    only a 4.75in fan hole, a 9x2in louver and a single 1in grommet. The
    cluster now mounts on its PANEL-B face, upper passenger corner, X 30-40
    and Z 8-14, standing ~2in off into Panel Bs bay. params.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
    [electrical_layout_detail.scad, fridge_install_detail.scad, panel_c_wall_detail.scad, params.scad, platform.scad, rear_view.scad, rear_view_deployed.scad]
2026-08-03 Spare is CENTRED in Panel B, so the cluster moves to the wall end column
    Owner confirmed the spare is centred. That pins down what stands against
    Panel Cs front wall on the Panel-B side, and it invalidates yesterdays
    placement:
    spare 28.5in centred in 46in -> x 8.75 - 37.25
    totes 2 x 16.9in on the spare -> x 6.10 - 39.90
    So the wall is NOT clear in the middle. What is clear, full height, is a
    ~6in column at each END. The cluster had been put at x 30-40, squarely
    inside both -- it would have been pressed against the tote wall.
    Reshaped from 10x6 to 5x11 -- tall and narrow -- and moved into the
    PASSENGER column: X 40.4-45.4, Z 3.5-14.5. It lands over the passenger
    front leg (x 41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
    [panel_c_wall_detail.scad, params.scad]
2026-08-03 Project Smores -> Project S'mores
    Renamed the display text in 12 places: the PDFs cover, its HTML title, the
    document title, the footer stamped on all 112 pages, the markdown H1, the
    eyebrow and title on the cut list, build sequence and shopping list, and
    the gear-deck footer (SMORES OUTDOORS -> S'MORES OUTDOORS).
    Two categories deliberately left alone:
    - the FILENAME Project_Smores.pdf, and the three places that name it in
    prose. An apostrophe in a filename breaks shell use, and the file is
    fetched over a GitHub raw URL that renaming would break. Since the
    filename is unchanged, the prose that cites it is still correct.
    - the localStorage keys smoresCut, smoresBuild and sm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
2026-08-08 Add the Sienna power-folding mirror install guide
    A print-ready PDF install guide for the aftermarket power-fold retrofit,
    generated from source by build_guide.py. Includes the original photos and
    forum screenshots under src/images/ plus the crop table and vector diagrams
    that produce the figures.
    Generated output (output/, src/assets/) is ignored - run make_assets.py then
    build_guide.py to reproduce the PDF.
2026-08-08 Credit the people this guide is compiled from, and add the liability disclaimer
    Front matter ahead of the content, on two new pages. The first names the
    installers, video authors and thread contributors whose work the guide is
    assembled from, states plainly that it is a compilation rather than original
    work, and records that all rights stay with their respective owners.
    The second carries a disclaimer of liability styled after the Project S'mores
    cover sheet, with the risks that actually apply to this job: stored spring
    energy, SRS wiring in the door, the optional factory-circuit tap, parts that
    are hard to source, and variation between sellers of similar kits.
    The disclaimer box is a sing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
2026-08-08 Fix two crop boxes: the cover-inside shot was framing the parking lot
    f_coverinside was cropped at y 200-700, but the mirror cover sits at roughly
    y 480-950 in that screenshot. The published image was mostly parked cars and
    window glass with only the top sliver of the part visible - on the page where
    the caption points at the cover's clips. Reframed onto the cover itself, with
    the bottom edge held clear of the ad banner over the foot of the image.
    tool_zoom was also pulling in a white strip off the right edge of the photo and
    an orange object in the bottom-left corner. Tightened so the drive lugs, which
    are the only reason the crop exists, sit unobstructed.
    Both verified against the regene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
2026-08-24 Delete the 3/8" sheet from the order and re-cut those parts from offcuts
    Three parts were the only reason to buy a third sheet of plywood. Each now
    comes out of what the other two sheets already waste:
    - Drawer box walls 3/8" -> 3/4", from the 3/4" sheet's own offcuts (one side
    and one front out of the 47x19 strip, the other two out of the anchor
    board's comb gaps). They need a 14.5" dimension and the 1/2" spare runs out
    after the front wall and fridge tray, so 3/4" is what is left that fits.
    - Panel C front wall and the fridge tray 3/8" -> 1/2", from the 1/2" leftover.
    It costs 16 lb (build total 469.9 -> 485.9). The drawer carries ~78 lb on a
    100 lb slide pair, so the margin thins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
    [params.scad, sheet_cut_layout.scad, weight_budget.csv]
2026-09-01 Add a legs-only subset PDF, and fix the leg numbers it exposed
    Project_Smores_Legs.pdf is a standalone 15-page document covering just
    the 12 platform legs: cut list and cutting plan, the bottom bore, the
    threaded insert, the leveling-foot stack A-E, leg position in each
    frame, the leveling procedure, the load check and a legs-only shopping
    list. build_legs_pdf.py reuses build_pdf.py's CSS, cover and footer
    stamp, so the subset prints like the parent document.
    Gathering the numbers turned up three that were stale:
    - Panel A and Panel B's parts lists called for 16" legs. They are
    15.25" (leg_cut_length_ab) - A/B run 3/4" shorter than Panel C
    because their deck sits ON the rails rather th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
    [leg_detail.scad, leveling_foot_detail.scad, panel_detail.scad]
2026-09-03 Lap the legs to the rails, which makes ten of them 1.5" longer
    The legs were butted UNDER the top rails, so their only fastening up
    there was 2 screws driven into end grain. They are lapped to the end
    rails' inner faces now, running flush with the rail tops, so the screws
    go through the rail's face into the leg's side and work in shear.
    leg_height keeps its old meaning -- the rail underside, i.e. the void
    under the deck -- so the fridge stack, the drawer height and Panel C's
    front wall are all where they were. The deck plane is still 18.5". What
    moved is the legs: 15.25" -> 16.75" on A/B, 16" -> 17.5" on Panel C's
    front pair, and 1.5" inboard along each panel's length.
    Panel C's REAR pair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
    [leg_detail.scad, lego_lib.scad, leveling_foot_assembly.scad, leveling_foot_detail.scad, panel_c_lego.scad, panel_detail.scad, params.scad, platform.scad]
2026-09-03 Fix the frame corners: side rails fit BETWEEN the end rails
    The 2x2 cut list had both rails at full size -- end rails 6x 46" (the
    full deck width) AND side rails at each panel's full length. That
    double-books 1.5 x 1.5in at all four corners of every panel, so the
    frames as listed could not be assembled. The geometry had the same
    error: module_frame() and lib_frame_ring() both drew all four rails
    full length and OpenSCAD quietly unioned the overlaps.
    End rails stay outboard. They are the face the lapped legs bear
    against, Panel C's 46" front wall matches them, and it is the end rail
    that covers Panel C's true-corner rear legs -- swapping which pair is
    outboard would break all three. So the S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
    [lego_lib.scad, panel_detail.scad, platform.scad]
2026-09-03 Read ply thicknesses off the parameter instead of retyping them
    Panel C's front wall went 3/8" -> 1/2" in the Aug 2026 no-3/8-buy round
    and pcwall_t was updated, but three drawings carried the thickness as a
    literal beside it and kept printing 3/8": the Panel C parts table, the
    front-wall flat pattern's own title, and (for the neighbouring parts in
    the same change) the drawer box's walls and the fridge tray on the
    anchor-board sheet. The markdown had it right the whole time, so the
    document and the drawings disagreed.
    Rather than retype the four numbers, added inch_frac() to params.scad --
    a decimal-to-shop-fraction label -- and had every one of those callouts
    derive from the parameter it d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
    [anchor_board_assembly.scad, panel_c_wall_detail.scad, panel_detail.scad, params.scad]
2026-09-03 Shop photos for the legs, and the bore goes 7/8" -> 1-3/4"
    Boring the real thing turned up a number that had never been checked
    against the part it has to clear. The bore was sized for the insert
    alone (3/4" of insert plus clearance = 7/8"), but the leveling bolt's
    STUD passes straight through the insert and keeps going as the foot
    winds in. At 7/8" the stud bottoms out on solid wood long before the
    foot is home, and the leg loses the bottom half of its travel. 1-3/4"
    gives the stud somewhere to go.
    bore_d/bore_dp were declared separately in leg_detail.scad and
    leveling_foot_assembly.scad, so the two sheets could have disagreed with
    each other. They are leveling_bore_dia / leveling_bore_dep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
    [leg_detail.scad, leveling_foot_assembly.scad, leveling_foot_detail.scad, panel_detail.scad, params.scad]
2026-09-03 Drop the no-slip pad photo; the bare nylon call stands
    Yesterday's photo set included a stick-on pad going onto a finished
    foot, and taking it at face value reversed this guide's standing advice
    to skip the kit's pads. That was the wrong read: the pad was tried, not
    adopted. Photo deleted, and the "skip the stick-on pads" note is back
    as it was -- bare nylon grips the van floor better and doesn't shed --
    now marked re-confirmed Sept 2026 so it does not get re-litigated by
    the next photo of a foot.
    The foot-threaded-home photo stays and does double duty: it is the one
    that shows the stud almost entirely inside the leg (why the bore is
    1-3/4"), and it now also shows what a finished foot's fac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
2026-09-03 Delete the star knob, move the leg photos into the main plan, retire the legs PDF
    THE KNOB IS GONE. A ~2" hand wheel on the bottom of all twelve legs took
    up too much room down there, so it and the 3/8-16 jam nut that locked it
    are deleted. The stud's fixed hex collar -- which this plan only ever
    described as "a wrench flat for breaking a seized foot loose" -- is now
    the only adjustment interface, so leveling is a wrench, not a hand grip.
    Three parts per foot, not five.
    The loudest warning in the leg section went with it: "lock the knob with
    the JAM NUT, never by jamming it on the fixed collar." With no knob
    there is nothing to lock, and the collar that rule warned against
    jamming on is sim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
    [leg_detail.scad, leveling_foot_assembly.scad, leveling_foot_detail.scad, panel_detail.scad, params.scad, weight_budget.csv]
2026-09-03 Wrap the two leg drawings so they stop running off the page
    The lap-joint sheet and the leg shop drawing went into Section 3 as bare
    markdown images. build_pdf.py deliberately has no blanket
    `img { max-width: 100% }` -- there is a comment next to `figure img`
    saying so, and saying exactly what happens: an image in neither a
    <figure> nor the Component-banner rule renders at its natural pixel
    width (3000px is ~31in at 96dpi) and runs off the right edge. Both are
    in <figure> blocks with captions now, and both fit the column. Page
    count is unchanged at 126.
    Audited the generated HTML for the same defect rather than fixing only
    the two that were reported. One more turned up: Appendix G's
    night-c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
2026-09-06 Bench-test the cooktop: P6+P6 is the real dual-burner ceiling, not 1800W
    The COOKTRON was run off the DELTA 3 Plus on the bench -- base unit, no
    Smart Extra Battery, van not involved at all. That is a fair stand-in for
    the real install: both inverters are 1500W, so the numbers transfer
    straight to the rear outlet. Section 7 gets the results as its own
    subsection, TESTED rather than estimated.
    WHAT IT DRAWS. One burner ramps P1 to P9 clean -- ~380W at P1, ~650-700W
    at P5-P6 (the stable setting for a long or unattended simmer), ~934-1000W
    at P9, no faults and no voltage instability anywhere on the ramp. Both
    burners at P6 pull ~1460W combined and hold it. Push either one to P9
    while both are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
2026-09-06 1800W is the COMBINED cap, not per burner -- and add publish_plan.py
    THE RATING WAS BEING READ WRONG, by this plan and probably by anyone
    cooking on it. The COOKTRON's 1800W is the ceiling for the WHOLE unit:
    the listing says the design ensures power will not exceed 1800 watts
    when both burners are in use. It is not 1800W a zone. The bench test
    already showed what that means in practice -- ~934-1000W at P9 on one
    zone -- but the plan described 1800W as a boost-mode figure, which was a
    guess and the wrong one.
    WHY IT MATTERS AT THE STOVE. A single pot never sees 1800W. With the
    second zone also running the unit splits its budget and that pot may be
    down to ~900W or less, which is a strong si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
2026-09-06 Frame screws go 2" -> 2-1/2": a 2" screw only bit 1/2" past the rail
    Every 2x2 frame joint -- the 12 corners, all 12 leg laps, the 2 butt-under
    rear legs, the 14 bottom-rail-to-leg joints -- sends the screw through a full
    1.5" rail before it reaches anything. At 2" that left half an inch of
    engagement, and at the corners that half inch is end grain. 2-1/2" gives a
    full inch with 1/2" of wood still beyond the tip, costs the same, and changes
    nothing else. Applied in 8 places. The cheeks, ply-to-frame and Panel A's
    bed-section screw-down stay at 2" -- they don't cross a rail, and 2-1/2"
    would punch through the bed section.
    Purchases recorded, all 2026-09-06:
    - All lumber: both plywood sheets,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
